baginski95/Home-automation-system/Praca dyplomowa - System sterowania wybranymi funkcjami instalacji w domu jednorodzinnym, Filip Bagiński.pdf

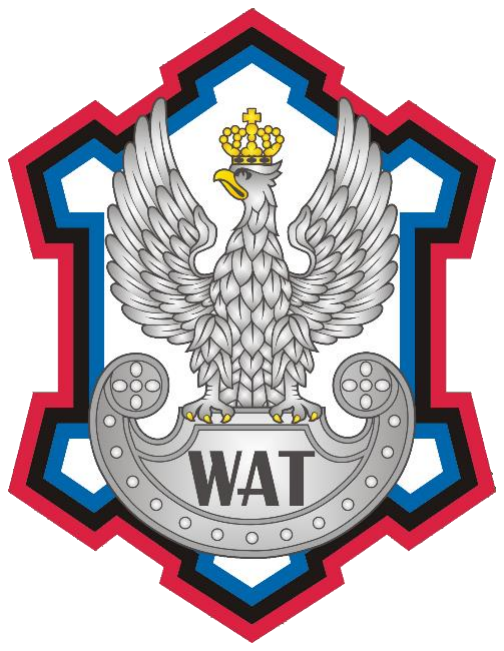
[picture p1: figure]

### WARSZAWA 2019

## WOJSKOWA AKADEMIA TECHNICZNA

### im. Jarosława Dąbrowskiego

## WYDZIAŁ ELEKTRONIKI

# PRACA DYPLOMOWA

### UKŁAD STEROWANIA WYBRANYMI FUNKCJAMI INSTALACJI W DOMU JEDNORODZINNYM

(temat pracy dyplomowej)
Filip Mikołaj BAGIŃSKI s. Jacka

(stopień wojskowy, tytuł zawodowy, imiona i nazwisko, imię ojca dyplomanta)

## ELEKTRONIKA I TELEKOMUNIKACJA

(kierunek studiów)
INŻYNIERIA SYSTEMÓW BEZPIECZEŃSTWA
(specjalność)
STACJONARNE STUDIA PIERWSZEGO STOPNIA - INŻYNIERSKIE
(forma i rodzaj studiów)*)

dr inż. Marek SUPRONIUK

(stopień wojskowy, tytuł i stopień naukowy, imię i nazwisko promotora pracy dyplomowej)

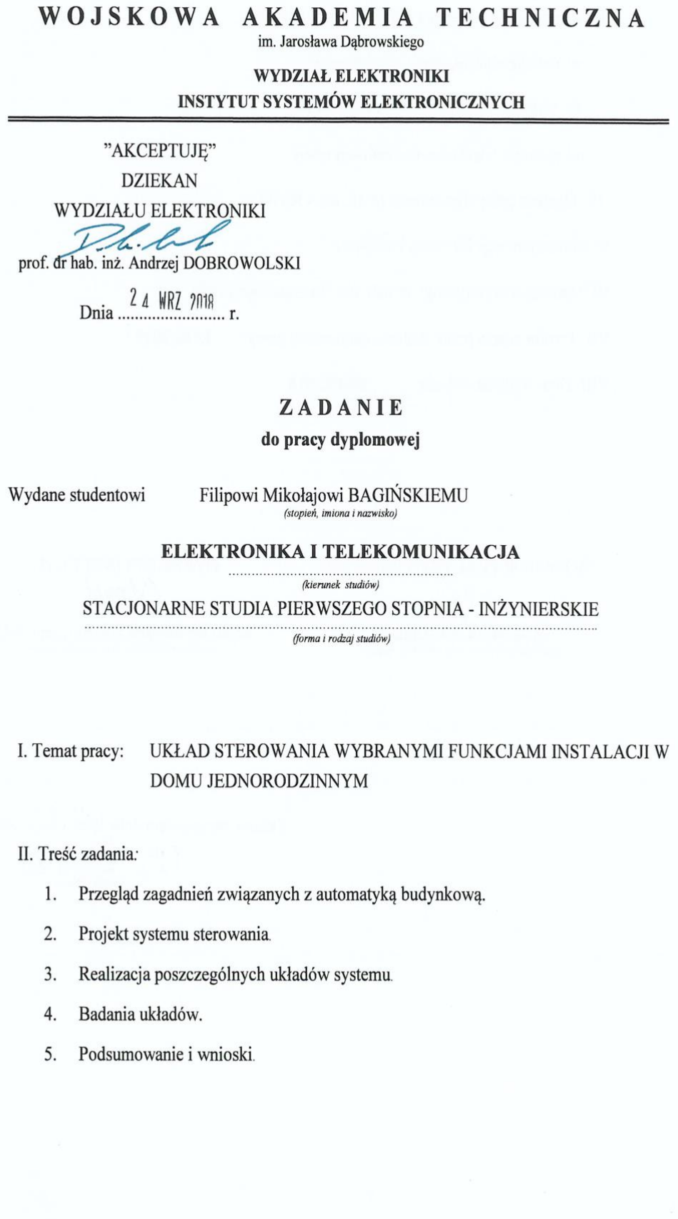
[picture p2: page 2]

### WARSZAWA 2019

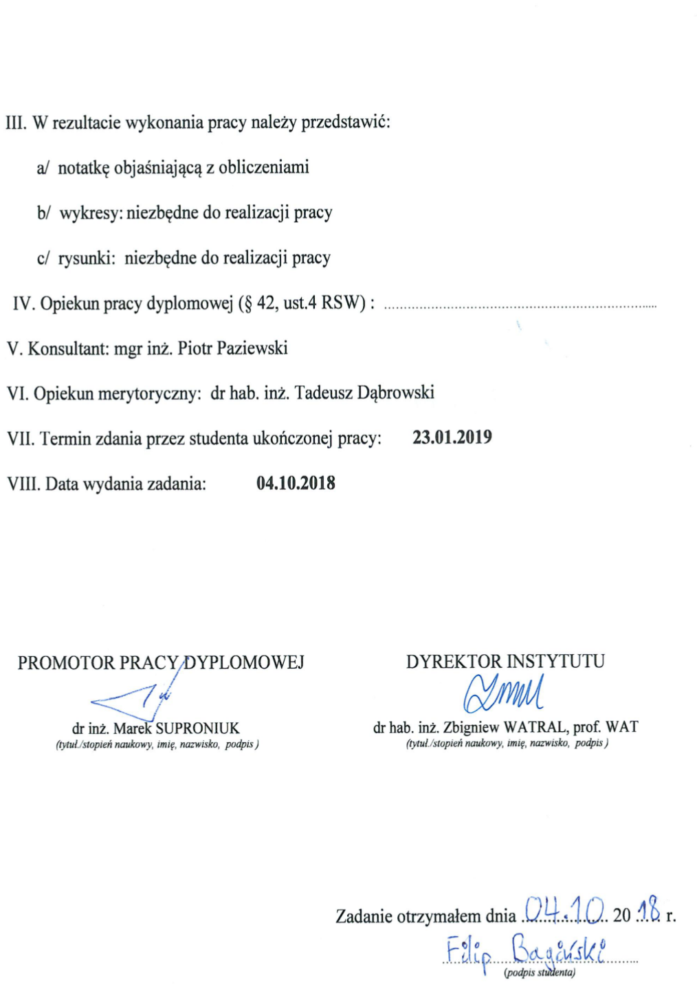
[picture p3: page 3]

### WARSZAWA 2019

SPIS TREŚCI

Wstęp

Pierwsze systemy automatyki domowej zostały stworzone już w ubiegłym wieku.

Zapewniają wygodę oraz bezpieczeństwo osób użytkujących, a także umożliwiają obniżenie

kosztów korzystania z energii elektrycznej. Pojęcie automatyki domowej obejmuje między

innymi systemy sterujące oświetleniem, obsługujące rolety, regulujące temperaturę

w pomieszczeniu, a także alarmowe, czy informujące o zagrożeniu życia lub zdrowia [1].

Bywają też bardzo pomocne dla osób o ograniczonych zdolnościach ruchowych.

W dzisiejszych czasach coraz częściej spotyka się domy wyposażone w systemy

zarządzające poszczególnymi funkcjami instalacji domowej. Pomimo spadku cen elementów

elektronicznych w ostatnich latach ceny systemów automatyki domowej są wciąż wysokie.

Niniejsza praca ma na celu stworzenie taniego systemu, który będzie sterować głównym

oświetleniem w pomieszczeniu, gniazdem elektrycznym oraz roletą. Komunikacja pomiędzy

układami realizowana będzie bezprzewodowo. W ramach pracy zostaną zaprojektowane i

zmontowane na płytkach uniwersalnych układ nadawczy w formie pilota posiadającego pięć

przycisków wraz z nadajnikiem podczerwieni oraz układy odbiorcze realizujące poszczególne

funkcje.

### 1. Przegląd wybranych systemów automatyki domowej

Na rynku jest wiele systemów automatyki domowej różnych producentów, które odróżnia

wykorzystana technologia, cena, sposób komunikacji pomiędzy układami oraz realizowane

funkcje.

### 1.1 Systemy bezprzewodowe

Systemy bezprzewodowe podczas montażu nie wymagają ingerencji w już istniejącą

instalację elektryczna. Z tego powodu zazwyczaj jego montaż jest łatwy. Wykorzystując

transmisję radiową w komunikacji pomiędzy układami mogą wystąpić zakłócenia. Poważną

wadą takich systemów jest konieczność użycia zasilania bateryjnego dla niektórych urządzeń,

co wymaga wymiany baterii po pewnym czasie.

a. Fibaro

Jeden z polskich systemów bezprzewodowych automatyki domowej, który umożliwia na

przykład sterowanie oświetleniem, roletami, zdalne monitorowanie budynku, a także może być

zintegrowany z systemami grzewczymi czy zabezpieczającymi. Głównym elementem systemu

jest centrala, która kontroluje całą jego prace. Urządzenia systemu Fibaro zawierają specjalny

układ obsługującego protokół Z-wave w celu komunikacji pomiędzy urządzeniami. Protokół

ten używa pasma o wartości 868,42 megaherców [2]. Sterowanie poszczególnymi modułami

spełniającymi określone funkcje odbywa się przy pomocy zwykłych włączników lub

korzystając z urządzeń mobilnych, czy poprzez stronę internetową.

b. xComfort

Kolejnym przykładem systemu bezprzewodowego może być xComfort, który ma

możliwość sterowania oświetleniem, temperaturą pomieszczenia, roletami oraz innymi

urządzeniami. Dodatkowo producent dostarcza | czujniki pozwalające na monitorowanie stanu
temperatury w pomieszczeniu, detekcję zalania, dymu, czy ruchu. | Posiada główną jednostkę

zarządzającą całym systemem, a sterowanie odbywa się przy użyciu sygnałów wysyłanych do

odbiorników sterujących poszczególnymi układami, które realizują odpowiednią funkcję.

Użytkownik obsługuje go przy pomocy aplikacji mobilnej, panelu zamontowanego na ścianie,

czy programowalnego pilota sterującego [4].

### 1.2 Systemy kablowe

Charakteryzują się przewodową komunikacją pomiędzy układami dzięki czemu transmisja

nie jest podatna na zakłócenia radiowe. Przeważnie są droższe od bezprzewodowych ,a podczas

montażu wymagają specjalistycznej wiedzy na jego temat.

a. KNX

Komunikacja pomiędzy układami tego systemu może być realizowana przy użyciu wielu

mediów transmisyjnych. Poprzez instalację elektryczną w budynku, fale radiowe, czy sieć

Ethernet. Jednak najczęściej stosowanym medium transmisji jest skrętka dwuparowa. Nie

posiada centrali, która zarządzałaby całą instalacją. Jest systemem rozproszonym. Korzysta z

Europejskiej Magistrali Komunikacyjnej opracowanej wspólnie przez europejskich

producentów systemów automatyki budynkowej. Stworzony standard komunikacyjny

umożliwia dołączenie do systemu urządzeń pochodzących od innych producentów. Instalacja

systemu KNX wymaga posiadania sporej wiedzy na jego temat, a także surowego stanu

budynku. Dzięki niemu możliwe jest między innymi sterowanie oświetleniem, temperaturą

pomieszczenia, roletami, kontrolą dostępu czy też zarządzanie systemem alarmowym [6].

b. Nexo

Polski system firmy Nexwell może sterować oświetleniem, roletami, regulować

temperaturę pomieszczenia oraz zarządzać systemem alarmowym. Współpracuje wyłącznie z

urządzeniami producenta. Zarządzanie poszczególnymi modułami i podejmowanie decyzji

odbywa się poprzez centralę. W razie uszkodzenia centrali nie będą dostępne zaawansowane

funkcje, lecz będzie można sterować poszczególnymi funkcjami przy użyciu włączników.

System może być obsługiwany za pomocą aplikacji mobilnej NexoVision, strony internetowej

oraz wiadomości SMS. Centrala przeważnie połączona jest z modułami przewodowo. Jednak

jest również możliwość komunikacji bezprzewodowej z modułami, które zostały do tego

zaprojektowane[2].

### 2. Przedstawienie projektu

Celem projektu jest wykonanie czterech urządzeń. Jednego układu nadawczego oraz trzech

układów odbiorczych, które mają pełnić funkcję prostego systemu realizującego poszczególne

funkcje automatyki domowej.

### 2.1. Założenia projektu

Zadaniem układu nadawczego jest możliwość przesyłania sygnału w podczerwieni przy

użyciu standardu RC5, który jest odbierany i dekodowany przez układy odbiorcze.

W zależności od użytego przycisku układu nadawczego przypisany do niego układ odbiorczy

reaguje i wykonuje odpowiednią funkcję.

Projekt ma pokazać, że przy niewielkim nakładzie finansowym i łatwo dostępnych

elementach elektronicznych jest możliwość stworzenia prostego systemu sterującego

wybranymi funkcjami instalacji w domu.

Na rys. 2.1. przedstawiony jest schemat blokowy opisywanego systemu składający się

z poszczególnych modułów układu nadawczego oraz modułów układów odbiorczych. Każdy z

układów posiada moduł odpowiedzialny za zasilanie. Układ odbiorczy nr 1 jest zasilany z sieci,

układ odbiorczy nr 2 bateryjnie, a układ odbiorczy nr 3 za pomocą akumulatora. Układ

nadawczy zawiera mikrokontroler, który odpowiedzialny jest za reakcję na odpowiedni

przycisk i wysłanie zakodowanej ramki danych poprzez nadajnik podczerwieni. Natomiast

zadaniem mikrokontrolerów znajdujących się w układach odbiorczych jest odebranie

zakodowanej ramki danych korzystając z odbiornika podczerwieni i wykonaniu odpowiedniej

funkcji jeżeli wysłana ramka danych skierowana jest do tego układu, a jeśli nie to

mikrokontroler porzuca odebraną ramkę danych i oczekuje na odebranie następnej. Układ

odbiorczy nr 1 włącza i wyłącza urządzenie podłączone do sieci. Zadaniem układu odbiorczego

nr 2 jest sterowanie oświetleniem, a układ odbiorczy nr 3 obsługuje silnik sterujący roletą.

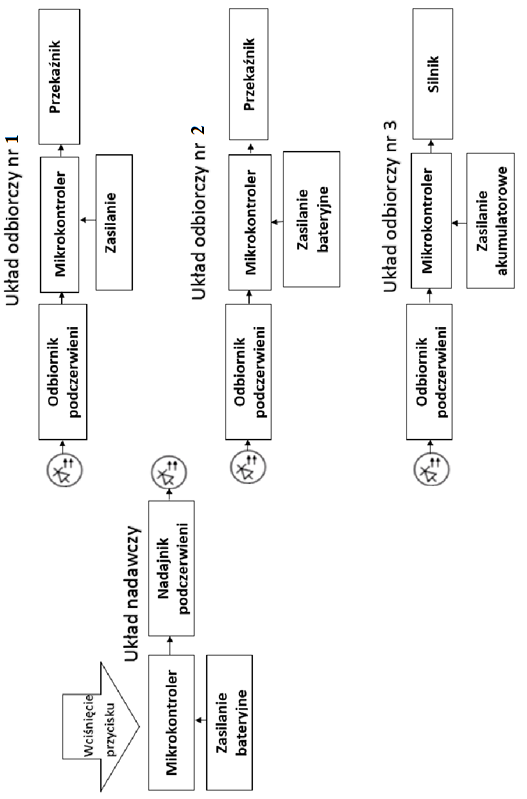
[picture p4: figure]

Rys. 2.1 Schemat blokowy systemu sterującego wybranymi funkcjami instalacji (opracowanie własne)

### 2.2. Opis standardu RC5

Wykorzystywany w projekcie standard RC5 jest jednym z wielu standardów kodowania

sygnałów w podczerwieni. Został stworzony przez firmę Philips ponad 30 lat temu w celu

przesyłania sygnałów z pilotów podczerwieni używanych w sprzęcie RTV.

Zgodnie z tym standardem ramka danych wysyłana z układu nadawczego zawiera 14 bitów.

Trzy początkowe bity to dwa bity startu informujące układ odbiorczy o nadchodzącej ramce

danych oraz bit toggle, który zmienia swój stan na przeciwny po każdym wciśnięciu przycisku.

Później występuje pięć bitów adresu przechowujących adres urządzenia do którego przesyłana

jest ramka. Dzięki nim układ odbiorczy ma możliwość wykrycia czy dana ramka wysyłana

przez układ nadawczy jest skierowana dla niego. Następnie 6 bitów określających funkcję do

wykonania przez układ odbiorczy. Opisywany standard bazuje na kodowaniu bifazowym.

Oznacza to, że każdy przesyłany bit w ramce danych określony jest przez dwa impulsy o

przeciwnych stanach logicznych. Każdy impuls trwa przez dokładnie określony fragment

czasu, w tym wypadku jest to około 889 mikrosekund. Dlatego też czas trwania całego bitu

wynosi około 1778 mikrosekund. Podczas transmisji wykorzystywana jest częstotliwość nośna

równa 36 kiloherców, która jest odpowiednio modulowana w celu uzyskania bitu o pożądanym

stanie logicznym [7]. Przykładowa ramka danych wysyłana przez układ nadawczy znajduje się

na rys. 2.2.

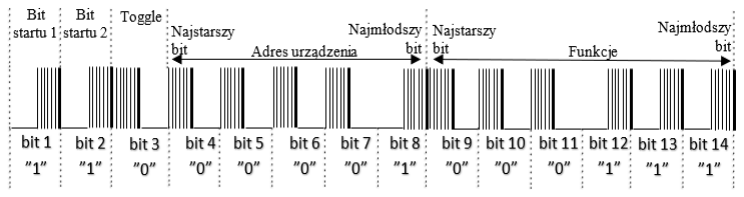
[picture p5: figure]

Rys. 2.2. Przykładowa konstrukcja ramki danych w standardzie RC5 wysyłanej przez układ nadawczy (opracowanie własne)

Od strony części odbiorczej po odfiltrowaniu częstotliwości nośnej przez odbiornik

podczerwieni na jego pinie sygnałowym generowana jest zanegowana ramka danych. Negacja

otrzymanej ramki spowodowana jest występującym tranzystorem bipolarnym na jego wyjściu.

Na rys. 2.3 pokazano ramkę widzianą od strony mikrokontrolera w układzie odbiorczym

wysłanej przez układ nadawczy w takiej konfiguracji, jak przedstawia rys. 2.2.

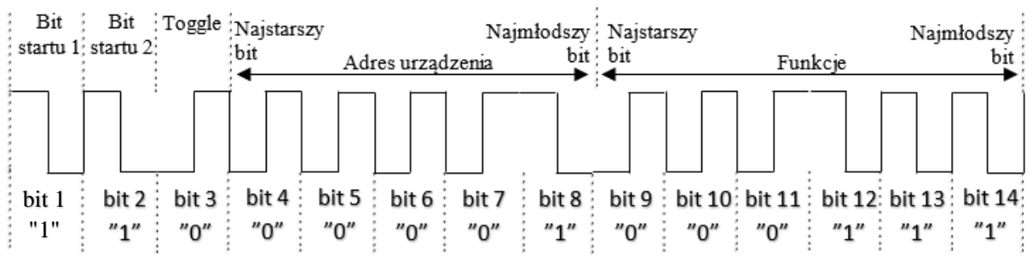
[picture p6: figure]
bit 1 "1"

Rys. 2.3 Konstrukcja ramki danych odebranej przez mikrokontroler w układzie odbiorczym (opracowanie własne)

Jeżeli układ nadawczy ma wysłać bit o wartości logicznej jeden potrzebna jest przerwa w

nadawaniu częstotliwości nośnej przez 889 mikrosekund, a następnie jej emitowanie przez

889 mikrosekund. Podczas wysyłania bitu o wartości logicznej zero należy pierw generować

częstotliwość nośną po czym następuje przerwa w jej emisji także w ciągu 889 mikrosekund.

Rys. 2.4 przedstawia, jak wysłać bit o pożądanych stanach logicznych dla standardu RC5.

Można zauważyć, że od strony układu nadawczego, każdy bit niosący informację posiada

zbocze w połowie okresu czasu trwania bitu [7].

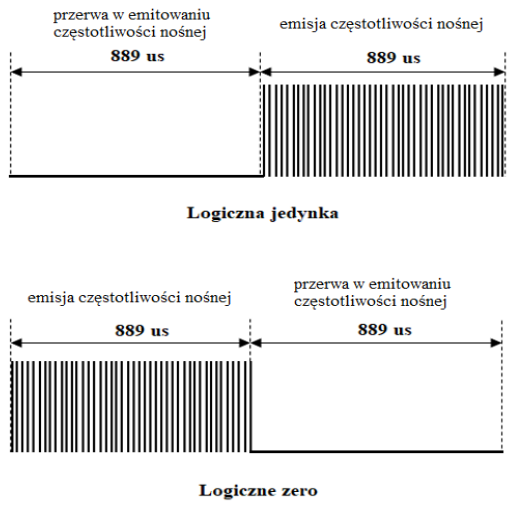
[picture p7: figure]

Rys. 2.4 Reprezentacja stanów logicznych dla układu nadawczego z częstotliwością nośną 36 kiloherców (opracowanie własne)

Dla wartości logicznej jeden jest to zbocze narastające, a bit o wartości logicznej zero

posiada zbocze opadające. W przypadku układu odbiorczego po odfiltrowaniu częstotliwości

nośnej sygnału przez odbiornik podczerwieni otrzymujemy poszczególne bity ramki danych w

postaci dwóch impulsów o różnych stanach. Mikrokontroler układu odbiorczego wykrywa stan

niski na pinie sygnałowym odbiornika podczerwieni podczas emitowania częstotliwości nośnej

przez układ nadawczy, a wykrywa stan wysoki podczas braku nadawania częstotliwości nośnej,

co pokazuje rys. 2.5. Występujący na wyjściu odbiornika podczerwieni tranzystor bipolarny

wchodzi w stan nasycenia po wykryciu fali nośnej, dlatego też odebranie sygnału w postaci fali

nośnej jest sygnalizowane stanem niskim. Podczas braku emitowania fali nośnej przez układ

nadawczy na wyjściu odbiornika podczerwieni panuje stan wysoki, co zapewnia rezystor

podciągający zawarty w jego budowie. Oznacza to, że stany logiczne poszczególnych bitów

wysłanych przez układ nadawczy są negowane przez odbiornik podczerwieni, co należy

uwzględnić podczas pisania kodu źródłowego dla układu odbiorczego.

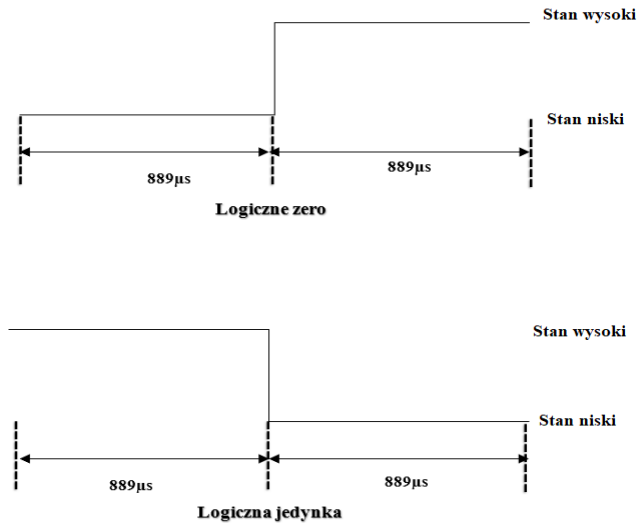
[picture p8: figure]

Rys. 2.5 Reprezentacja stanów logiczny dla układu odbiorczego po odfiltrowaniu częstotliwości nośnej przez odbiornik podczerwieni (opracowanie własne)

Przedstawione wyżej informacje są wystarczające, aby napisać kod źródłowy dla układu

nadawczego w celu nadawania ramki danych w standardzie RC5 oraz dla układów odbiorczych,

które będą miały możliwość dekodowania nadsyłanych ramek danych.

### 2.3. Dobór platformy

Ważną decyzją jest dobór platformy na której będzie opierał się cały system. Obecnie na

rynku jest wiele dostępnych urządzeń takich, jak mikrokontrolery, płytki rozwojowe, czy też

komputery jednopłytkowe.

a. Raspberry Pi

Platforma ta jest jednopłytkowym komputerem osobistym. Posiada własny system

operacyjny Raspbian, który jest częścią rodziny Linux. Raspberry Pi wyposażony jest

w procesor BCM2837, który jest wyposażony w cztery 64-bitowe rdzenie Cortex-A53 [10].

Na płytce znajdują się moduły wi-fi oraz Bluetooth. Jest też złącze HDMI służące do

podłączenia monitora oraz złącza USB, dzięki którym możemy podłączyć mysz oraz

klawiaturę. Zasilanie doprowadzone jest przez złącze USB. W projekcie nie zostanie

wykorzystana opisywana platforma z powodu nadmiernej ilości zbędnych modułów oraz

trudności napisania kodu programu, który miałby na celu realizować transmisję przy

wykorzystaniu standardu RC5.

b. Arduino

Gotowy zestaw uruchomieniowym, który został stworzony, dla osób chcących nauczyć się

pisać programy dla mikrokontrolerów, ale nie miały z tym za dużo wspólnego. Platforma

wykorzystuje mikrokontrolery z rodziny AVR. Zasilanie odbywa się przez złącze USB

znajdujące się na płytce ewaluacyjnej. Do wgrania kodu źródłowego nie jest potrzebny

zewnętrzny kompilator, ponieważ płytka wyposażona jest już w zaprogramowany

mikrokontroler służący do komunikacji z komputerem. Programowanie Arduino wspierane jest

przez oprogramowanie komputerowe, które zawiera biblioteki ułatwiające pisanie kodu

źródłowego mikrokontrolera, dzięki czemu nie trzeba znać poszczególnych nazw rejestrów

mikrokontrolera AVR. Arduino nie zostanie wykorzystana w projekcie z powodu miejsca

w obudowie jakie urządzenia mogłyby zajmować, gdyby została użyta ta platforma [11].

c. STM32

Są to mikrokontrolery 32-bitowe. W swojej strukturze zawiera wiele portów

wejścia/wyjścia, zegarów, konwerterów analogowo-cyfrowych oraz wielu innych modułów.

Producent udostępnia pokaźną ilość bibliotek pomagających napisać kodu źródłowy, ponieważ

napisanie programu dla mikrokontrolera 32-bitowego nie jest łatwym zadaniem i zazwyczaj

wymaga dobrej znajomości architektury mikrokontrolera oraz wygenerowania dużej ilości

kodu w celu wykonania prostych funkcji dlatego nie będzie on wykorzystany w niniejszym

projekcie.

d. AVR

Rodzina tych 8-bitowych mikrokontrolerów dzieli się na dwa typy. Jednym z nich jest

ATtiny, którego zasoby sprzętowe są stosunkowe małe, niewielka ilość pamięci operacyjnej

oraz przechowującej kod źródłowy. Posiadają przynajmniej jeden zegar sprzętowy. ATtiny

umieszczone jest w małej obudowie, która zawiera 6 pinów w najmniejszej wersji. Kolejnym

typem tej rodziny mikrokontrolerów jest ATmega, który ma większe zasoby sprzętowe, niż

ATtiny. Posiada więcej pamięci operacyjnej oraz pamięci FLASH. Ma przynajmniej dwa

zegary sprzętowe. W swojej strukturze zawiera przetworniki analogowo-cyfrowe, a jego

budowa zawiera do 100 pinów. Producent tych mikrokontrolerów udostępnia biblioteki przez

co dostęp do poszczególnych rejestrów mikrokontrolera zarządzających jego pracą jest bardzo

prosty. Z uwagi na małą zajętość miejsca oraz prostotę programowania tych mikrokontrolerów

oba typy zostały użyte w niniejszym projekcie.

### 3. Układ nadawczy

### 3.1. Budowa układu nadawczego

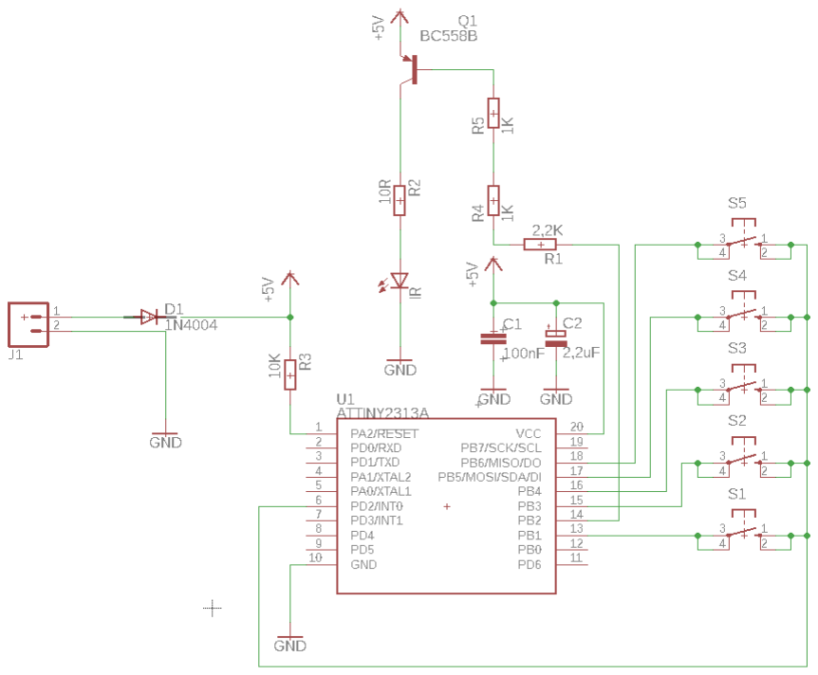
[picture p9: figure]

Rys. 3.1 Schemat połączeń dla układu nadawczego (opracowanie własne)

Na rysunku 3.1 znajduje się schemat połączeń pomiędzy elementami układu nadawczego.

Układem zarządza niewielki mikrokontroler ATtiny2313 do którego doprowadzonych jest pięć

przycisków. Każdy z klawiszy podłączony jest wspólnym połączeniem do pinu PD2, który

wykorzystano do wykrywania przerwań zewnętrznych w tym przypadku wywołanych

naciśnięciem przycisku. Z drugiej strony każdy przycisk podłączony jest do innego pinu portu

B, aby mikrokontroler był w stanie zidentyfikować naciskany przycisk. Rezystory R1, R4 i R5

zostały użyte w celu ograniczenia natężenia prądu płynącego przez bazę tranzystora. Pin PA2

należy doprowadzić do dodatniej szyny zasilania, ponieważ jedną z ról tego pinu jest

resetowanie mikrokontrolera, jeżeli wystąpi na nim stan niski. Zastosowano rezystor R1 w celu

ograniczenia prądu pobieranego przez pin PA2. Pin VCC podłączono do dodatniej szyny

zasilania, a pin o nazwie GND doprowadzono do ujemnego bieguna baterii. Są to piny

odpowiedzialne za zasilanie mikrokontrolera. Różnica potencjałów pomiędzy tymi pinami

powinna zawierać się w przedziale od 4,5 woltów do 5,5 woltów jak wynika to z noty katalogowej. Z powodu braku dostępności baterii o takiej wartości napięcia, a zarazem małych

rozmiarach w projekcie użyto baterii o wartości napięcia 6 woltów. Dioda prostownicza

1N4004 chroni układ przed niepoprawnym podłączeniem biegunów baterii do układu.

Dodatkowo podczas normalnej pracy na diodzie odkłada się napięcie o wartość 0,7 woltów

przez co różnica potencjałów pomiędzy pinami VCC i GND jest zgodna z zaleceniami

producenta. Złącze J1 służy do podłączenia baterii. Pomiędzy pinem VCC do którego

doprowadzone jest zasilanie, a masą zostały włączone równolegle kondensator elektrolityczny

oraz ceramiczny, których zadaniem jest odpowiednia filtracja zasilania. Pomimo zasilania

stałym napięciem do zasilania przedostają się zakłócenia spowodowane impulsową pracą

nadajnika podczerwieni, a także charakterem pracy samego mikrokontrolera, którego wartość

taktowania zegara została ustawiona programowo na wartość 8 megaherców. Poprzez pin PB2

sterowany prądem bazy tranzystor będzie włączał i wyłączał diodę podczerwieni zgodnie ze

standardem RC5 w celu wysłania ramki danych skierowanej do układu odbiorczego

przypisanego do konkretnego klawisza. Rezystor R2 ogranicza prąd płynący przez diodę

podczerwieni.

### 3.2. Nadajnik podczerwieni

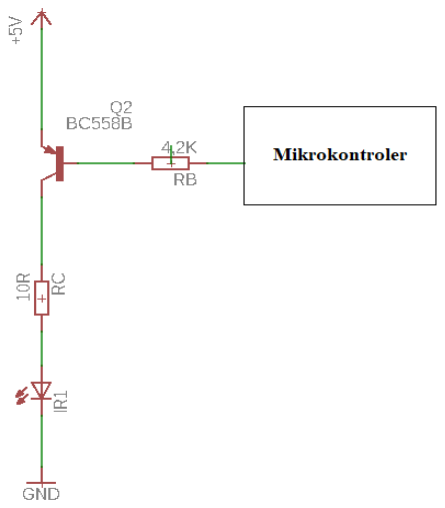
[picture p10: figure]

Rys. 3.2 Schemat nadajnika podczerwieni (opracowanie własne)

Rysunek 3.2 przedstawia jeden z elementów układu nadawczego jakim jest nadajnik

podczerwieni składający się z diody L-53F3BT emitującej falę o długości 940 nanometrów,

która zawiera się w zakresie bliskiej podczerwieni. Wartość ta została określona na podstawie

umieszczonej na rys. 3.3 charakterystyki przedstawiającej zależność intensywności

promieniowania diody od długości emitowanej fali. Kolejnym elementem jest tranzystor PNP

BC558B pracujący jako wzmacniacz w układzie z wymuszonym prądem bazy. W celu

wymuszenia stałego natężenia prądu bazy IB łączy się bazę tranzystora poprzez rezystor RB z

masą wtedy też następuje przepływ prądu kolektora. Obciążeniem tranzystora jest wyżej

wymieniona dioda wraz z szeregowo połączonym rezystorem RC. Zadaniem rezystora RC oraz

RB jest nie tylko odpowiednie zasilenie tranzystora, ale także ustalenie jego stałoprądowego

punktu pracy, czyli stałego napięcia kolektor-emiter UCE i stałego prądu kolektora IC.

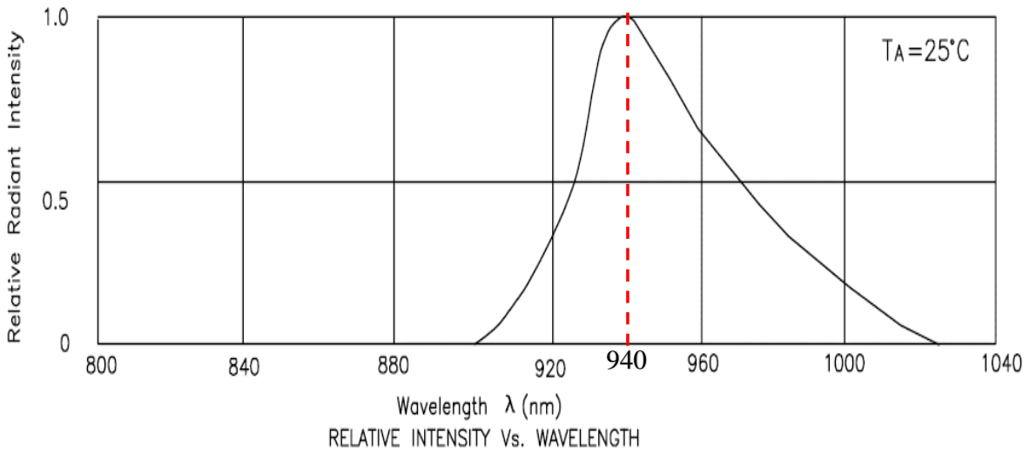
[picture p11: figure]

Rys. 3.3 Zależność intensywności promieniowania diody L-53F3BT od długości emitowanej fali [12]

### 3.3. Dobór elementów nadajnika podczerwieni

Na podstawie noty katalogowej diody podczerwieni emitującej światło podczerwone można

wywnioskować, że maksymalny prąd stały, jaki możemy przez nią przepuścić jest równy 50

miliamperów. Nadajnik podczerwieni projektowany jest tak, aby na diodzie wydzielała się

największa możliwa moc, ponieważ ma to wpływ na zasięg emitowania fali. Na rys. 3.4

znajduje się charakterystyka diody opisująca zależność pomiędzy prądem diody, a jej

napięciem pracy.

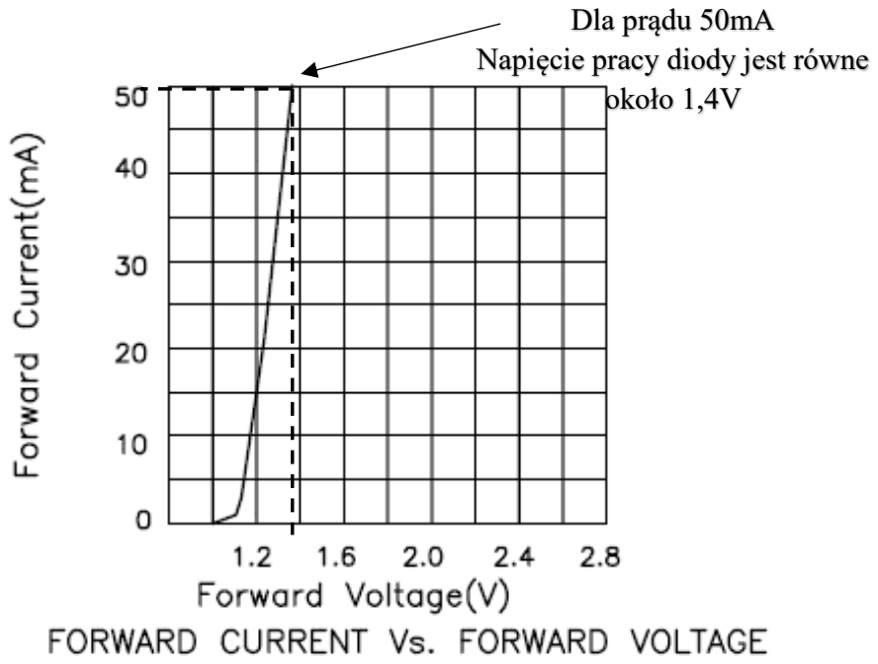
[picture p12: figure]
Dla prądu 50mA Napięcie pracy diody jest równe około 1,4V

Rys. 3.4 Zależność pomiędzy natężeniem prądu diody, a napięciem pracy diody L-53F3BT [12]

Nadajnik podczerwieni będzie emitował falę z częstotliwością 36 kiloherców, gdzie przez

połowę okresu tranzystor będzie w stanie nasycenia i dioda będzie emitowała falę nośną, a

przez drugą połowę okresu tranzystor będzie zatkany i prąd przez diodę nie będzie płynął.

Dzięki takiej pracy nadajnika podczerwieni można zwiększyć moc wydzielaną przez diodę. Z

noty katalogowej diody wynika, że maksymalna moc ciągła wydzielana na diodzie może być

równa 100 miliwatów. Jednak diody podczerwieni przystosowane są do pracy impulsowej. I w

tym wypadku wypełnienie impulsów wynosi 50% jak wynika z omawianego wcześniej

standardu RC5. Korzystając z poniższego wzoru można w przybliżeniu obliczyć maksymalny

prąd w impulsie.

IPMAX =

PMAX
(UD ∙ kD)

=

100mW
(1,4V ∙ 50%)

= 143 mA (1)

Gdzie:

IPMAX - maksymalny prąd w impulsie

PMAX - maksymalna moc ciągła

UD - napięcie pracy diody

kD- wypełnienie impulsów

Mając wartość maksymalnego prądu w impulsie IPMAX oraz napięcie pracy diody UD można

przystąpić do obliczenia wartości rezystancji RC oraz RB. Rysunek 3.5 obrazuje rozkład prądów

i napięć dla nadajnika podczerwieni. Dla napięcia zasilającego UZAS równego 5 woltów

założony punkt pracy tranzystora ma wartości IC wynoszącą 143 miliamperów z powodu

obliczonego maksymalnego prądu w impulsie dla diody podczerwieni oraz napięcia kolektor-

emiter tranzystora UCE wynoszącego -2 woltów. Pokazana na rys. 3.6 charakterystyka pozwala

na wyznaczenie napięcia między bazą, a emiterem UBE w zależności od prądu kolektora IC. W

projekcie przyjęto wartość napięcia UBE równą -0,8 woltów. W celu wyznaczenia prądu bazy

IB potrzebna jest wartość współczynnika wzmocnienia tranzystora hFE, którą można wyznaczyć

korzystając z charakterystyki udostępnionej w nocie katalogowej, a przedstawionej na rys. 3.7.

Posiadając wyżej wymienione wartości można przystąpić do obliczeń.

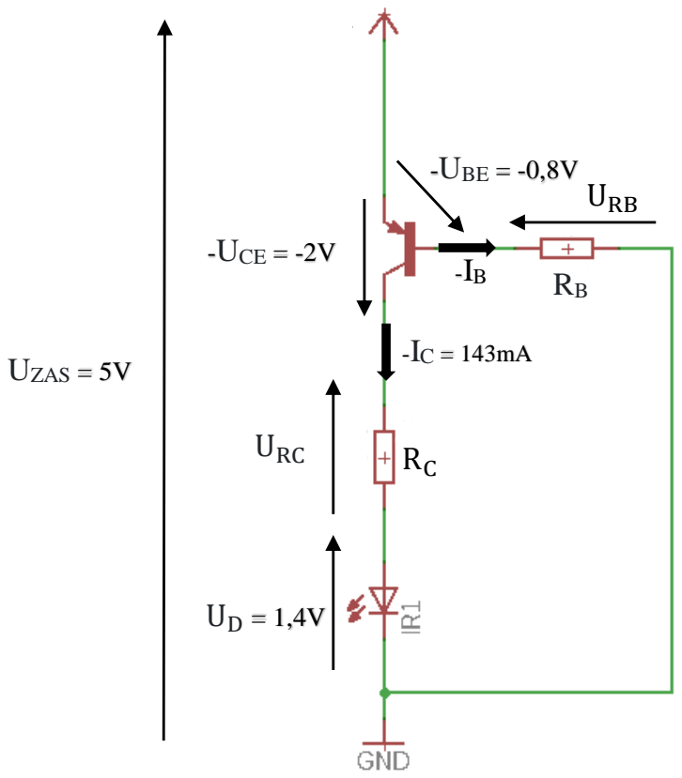
[picture p13: figure]
UZAS; -UBE; -UCE; URC; URB

Rys. 3.5 Rozkład napięć i prądów nadajnika podczerwieni (opracowanie własne)

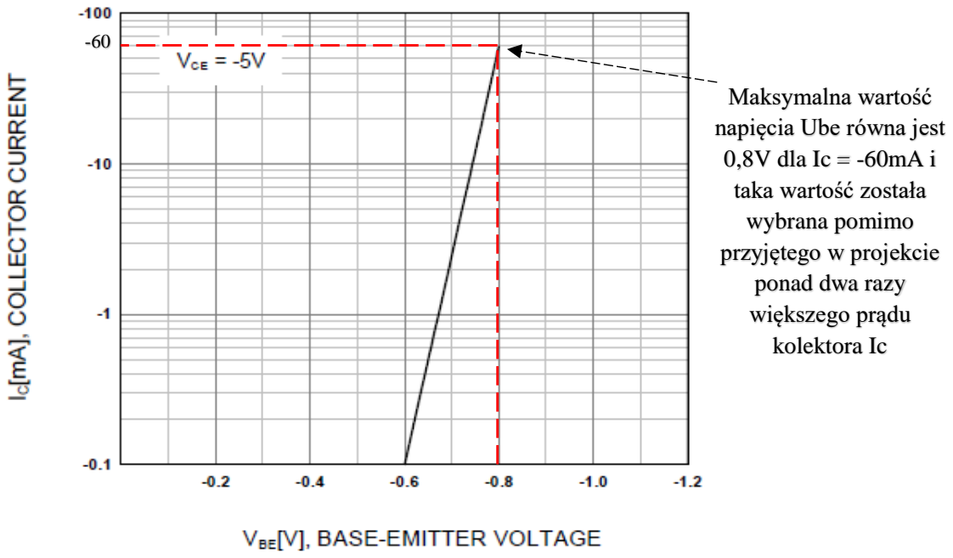
[picture p14: figure]
Maksymalna wartość napięcia Ube równa jest 0,8V dla Ic = -60mA i taka wartość została wybrana pomimo przyjętego w projekcie ponad dwa razy większego prądu kolektora Ic

Rys. 3.6 Zależność między napięciem baza-emiter UBE, a prądem kolektora IC dla tranzystora BC558B [13]

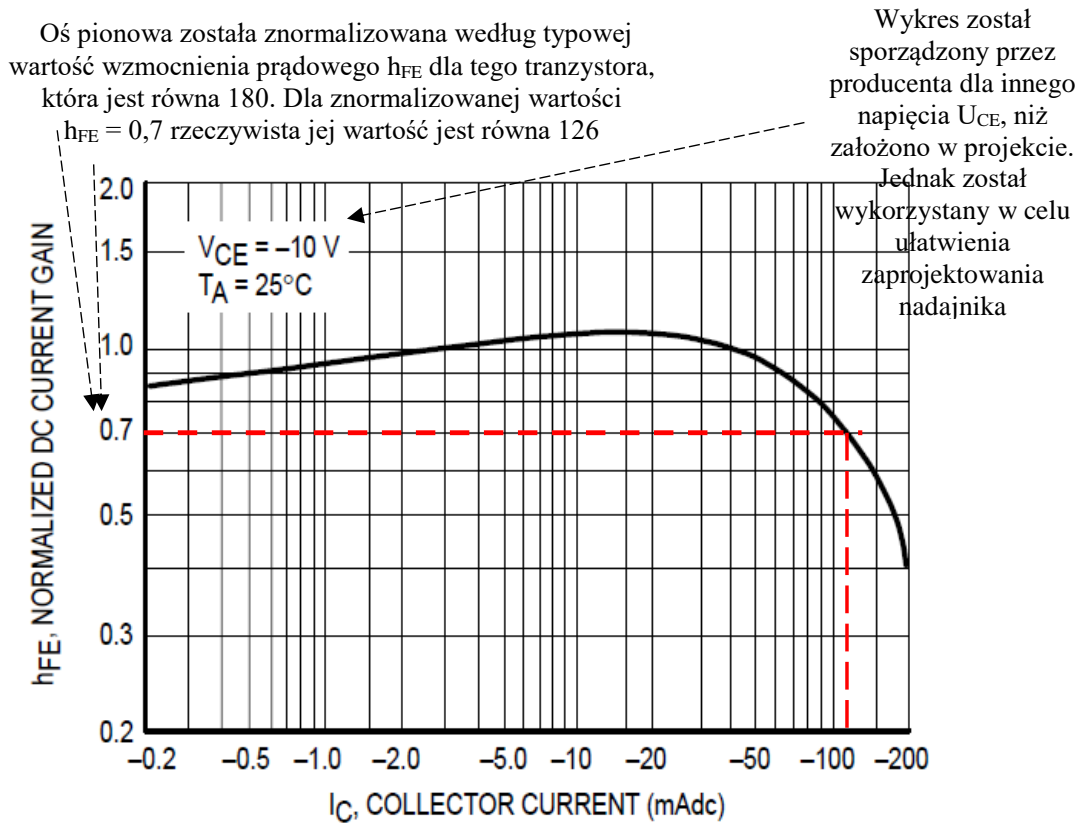
[picture p15: figure]
Wykres został sporządzony przez producenta dla innego napięcia UCE, niż założono w projekcie. Jednak został wykorzystany w celu ułatwienia zaprojektowania nadajnika

Rys. 3.7 Zależność wzmocnienia prądowego hFE od prądu kolektora IC dla tranzystora BC558B [13]

Na podstawie II prawa Kirchhoffa oraz prawa Ohma przy pomocy zaznaczonych na rys. 3.5

rozkładem napięć i prądów można wyprowadzić wzory na szukane rezystancje RC oraz RB.

Oś pionowa została znormalizowana według typowej wartość wzmocnienia prądowego hFE dla tego tranzystora, która jest równa 180. Dla znormalizowanej wartości hFE = 0,7 rzeczywista jej wartość jest równa 126

Obliczanie rezystancji RC:

Wzór opisujący drugie równanie Kirchhoffa dla oczka z kolektorem i emiterem:

UZAS | = UD | + URC − (−UCE) = UD | + IC | ∙ RC − (−UCE) | (2)
UZAS − UD | + (−UCE) = IC | ∙ RC
RC | =
[UZAS − UD | + (−UCE)]
IC

RC =

| | (5V − 1,4V − 2V)
0,143A | = 11,188Ω ≈ 11Ω

Obliczanie rezystancji RB:

Uproszczony wzór na zależność prądu bazy IB od prądu kolektora IC :

| | IB = IC hFE
(3)

IB =

0,143A
126 = 1mA

Wzór opisujący drugie równanie Kirchhoffa dla oczka z bazą i emiterem:

UZAS = URB + (−UBE) = IB ∙ RB + (−UBE) (4)

UZAS − (−UBE) = IB ∙ RB

RB =

[UZAS − (−UBE)]
IB

RB =

(5V − 0,8V)
0,001 A

= 4,2kΩ

### 3.4. Prototyp

Załączony na rys. 3.8 prototyp układu nadawczego został zbudowany na płytce stykowej.

Zmontowany układ ma na celu zbadanie poprawności wysyłanych bitów, co jest warunkiem

poprawnej komunikacji pomiędzy układami. Docelowo układ będzie zasilany baterią 6

woltową jednak prototyp układu zasilany jest z zasilacza firmy Samsung, którego napięcie

wyjściowe wynosi 5 woltów, co niweluje potrzebę obniżenia napięcia zasilania do wymaganej

wartości.

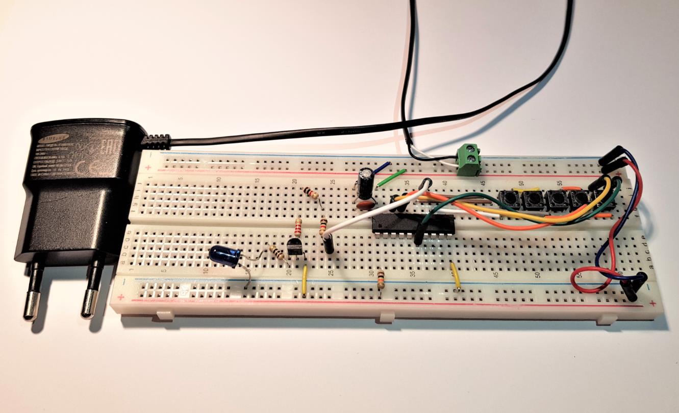
[picture p16: figure]

Rys. 3.8 Prototyp układu nadawczego (opracowanie własne)

Przy pomocy multimetru zmierzono wartość 1,41 woltów napięcia pracy diody

podczerwieni, która nieco odbiega od założonych wartości. Również założone natężenie prądu

kolektora IC odbiega od rzeczywistego. Multimetr zmierzył wartość natężenia prądu kolektora

równą 86 miliamperów przez co założony punkt pracy tranzystora różni się od rzeczywistego.

Podczas pomiaru napięcia pracy diody oraz prądu kolektora nóżka bazy tranzystora została

doprowadzona poprzez rezystory o obliczonej wartości 4,2 kiloomów do masy układu. Pomiar

tych wartości przy założonej w projekcie pracy impulsowej nadajnika podczerwieni byłby mało

wiarygodny dla wykorzystywanego multimetru i dlatego pomiary zostały wykonane bardzo

szybko z powodu możliwości uszkodzenia elementów nieprzystosowanych do pracy ciągłej dla

tak dużego natężenia prądu. Różnice między wartościami założonymi i pomierzonymi

wynikają z użycia kilku uproszczeń, które miały na celu ułatwić zaprojektowanie nadajnika

podczerwieni. Otrzymane wartości działającego układu są akceptowalne w ramach projektu.

Jednak będzie to miało wpływ na długość zasięgu emitowanej fali.

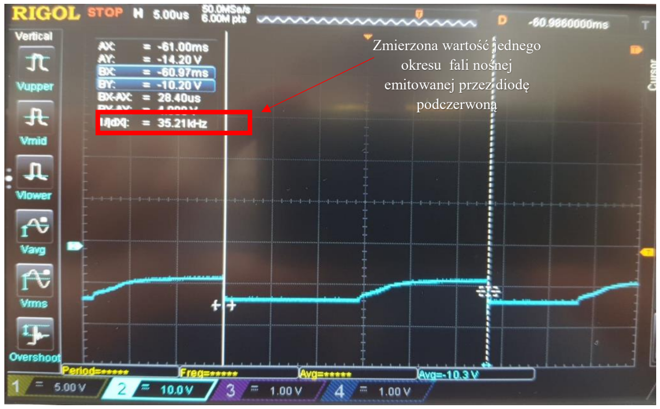
[picture p17: figure]
Zmierzona wartość jednego okresu fali nośnej emitowanej przez diodę podczerwoną

Rys. 3.9 Przebieg napięcia odkładanego na diodzie podczerwieni podczas emitowania fali nośnej (opracowanie własne)

W celu sprawdzenia częstotliwości nośnej sygnału emitowanego przez układ nadawczy

podłączono sondy oscyloskopu do anody oraz katody diody podczerwonej. Rysunek 3.9

przedstawia zaznaczony wskaźnikami pionowymi jeden okres tego sygnału. Zmierzona

oscyloskopem wartość częstotliwości nośnej wyniosła 35.21 kiloherców. Częstotliwość nośna

emitowanego sygnału jest bardzo zbliżona do wartości założonej w projekcie. Różnice w

wartościach wynikają z błędów pomiarowych oraz samej pracy mikrokontrolera. Pomimo tej

różnicy układy odbiorcze przy pomocy odbiornika podczerwieni będą odbierały nadchodzący

sygnał, ponieważ zawiera w swojej budowie filtr środkowoprzepustowy o częstotliwości

środkowej równej 36 kiloherców, który będzie w bardzo małym stopniu tłumił częstotliwość

nośną nadsyłanego sygnału. Jak można zauważyć zbocza narastające nie są strome z powodu

charakteru pracy tranzystora.

### 3.5. Oprogramowanie

Dla mikrokontrolera układu nadawczego okd źródłowy zawarty w załączniku został

napisany w języku C na podstawie informacji zawartych w książce [7] przy użyciu platformy

programistycznej Eclipse. Produkcyjnie mikrokontrolery ATmega mają ustawioną

częstotliwość taktowania 1 megaherca. Rysunek 3.10 ukazuje zrzut ekranu jednej z zakładek

programu mkAVRCalculator w której można zmienić częstotliwość taktowania używanego mikrokontrolera. W celu poprawnego działania programu ustawiono częstotliwość taktowania

8 megaherców.

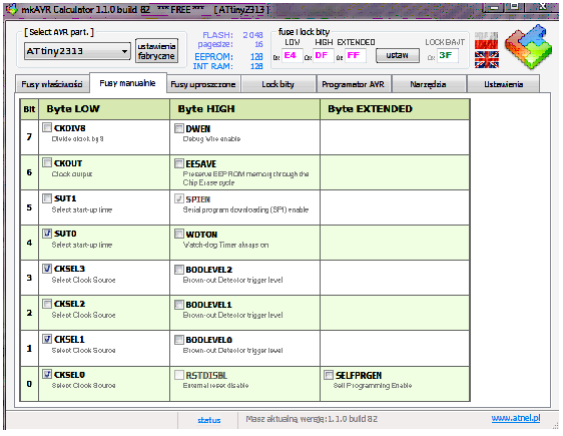
[picture p18: figure]

Rys. 3.10 Zrzut ekranu jednej z zakładek programu mkAVRCalculator (opracowanie własne)

Kod źródłowy został wgrany na mikrokontroler ATtiny2313 za pomocą programatora

USBasp pokazanego na rys. 3.11, który przeznaczony jest do pracy z mikrokontrolerami

z rodziny AVR. Programator pośredniczy w komunikacji pomiędzy mikrokontrolerem, a

komputerem. Napisany program wykorzystując rejestr określający kierunek pinów DDRB

ustawia pin PB2 jako wyjście, aby móc sterować pracą nadajnika podczerwieni. Za pomocą

rejestru TCCR0A oraz TCCR0B użyto zegar sprzętowy, który pozwala generować na PB2

sygnał o częstotliwości 36 kiloherców. Za pomocą rejestrów określających kierunki pinów

podłączone do portu B przyciski zostały ustawione jako wyjścia, a pin PD2 jako wejście.

W pętli głównej programu znajduje się jedynie funkcja wprowadzająca mikrokontroler w stan

niskiego poboru energii, a wyłączany jest po wykryciu przerwania wywołanego stanem

wysokim na PD2. Część kodu źródłowego odpowiedzialna za wysłanie ramki o odpowiednich

wartościach zawarta jest w tym przerwaniu aktywujące się przy wciśnięciu jednego z

przycisków. Mikrokontroler sprawdza jaki przycisk został użyty wykorzystując do tego rejestr

PINB i zaczyna nadawać przypisaną do niego ramkę danych o odpowiednich wartościach.

Emitowanie i przerwa w emitowania częstotliwości nośnej przez okres 889 mikrosekund

odbywa się przy użyciu funkcji wykorzystującej pracę drugiego zegara sprzętowego, który jest

ustawiony za pomocą jego rejestrów TCCR1B, TIFR oraz OCR1A w taki sposób, aby móc

określać czas trwania emitowania częstotliwości nośnej lub jej braku. Zmienna funkcji

określana jest w mikrosekundach. Następnie wykorzystano dwie funkcje wyślij_1 oraz wyślij_

wykorzystując powyżej opisaną funkcję wysyłają bity o odpowiadającej im wartości logicznej.

Działanie tych funkcji polega na odpowiednim włączeniu zegara pierwszego wykorzystując

jego rejestr TCCROA, który odpowiedzialny jest za włączenie generowania sygnału o danej

częstotliwości na pinie PB2.

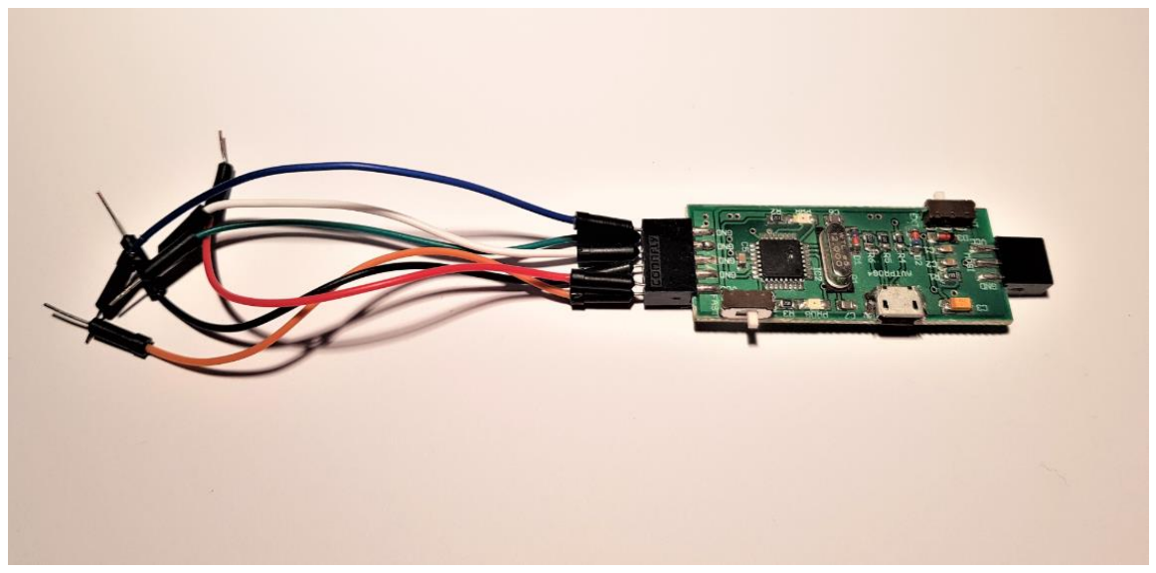
[picture p19: figure]

Rys. 3.11 Fotografia przedstawiająca programator USBasp (opracowanie własne)

### 4. Układy odbiorcze

### 4.1. Budowa układu odbiorczego nr 1

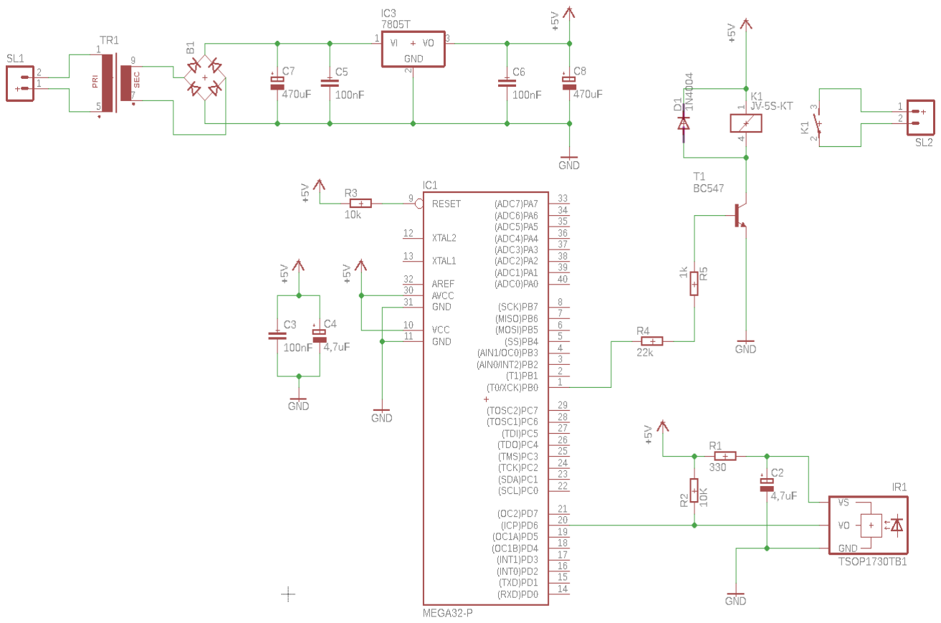
[picture p20: figure]

Rys. 4.1 Schemat układu odbiorczego nr 1 (opracowanie własne)

Na rys. 4.1 pokazany został schemat układu odbiorczego nr 1 różniącego się od układ

odbiorczego nr 2 wyłącznie fragmentem układu odpowiedzialnym za doprowadzenie zasilania.

Z powodu funkcji jaką będzie spełniał jest możliwość doprowadzenia z sieci zasilania prądu

przemiennego o napięciu skutecznym 230 woltów. W celu obniżenia napięcia zasilania do 12

woltów prądu przemiennego zastosowano transformator obniżający napięcie TSZZ 2/007.

Podczas jego wyboru kierowano się napięciem wtórnym, którego wartość powinna być większa

niż wartości napięcia na wyjściu stabilizatora napięcia. Poprawna praca stabilizatora wymaga,

aby jego napięcie wyjściowe było o 2,5 wolta niższe niż napięcie wejściowe. Mając na uwadze

spadki napięć na diodach prostowniczych mostka Graetza przyjęto minimalną różnicę napięć

pomiędzy wejściem stabilizatora, a transformatorem równą 4 wolty. Zwrócono również uwagę

na jego wymiary oraz maksymalne natężenie prądu jakie można uzyskać na wyjściu

transformatora, które powinno być większe od natężenia prądu pobieranego przez układ

odbiorczy. W celu przekształcenia prądu przemiennego na jednokierunkowy prąd tętniący

użyto pełno okresowego prostownika jakim jest mostek Graetza. W każdym półokresie odkłada

się napięcie o wartości 0,7 woltów na każdej z dwóch diod prostowniczych. W Układzie zasilania znajduje się stabilizator napięcia LM7805, który utrzymuje stabilne napięcie na jego

wyjściu o stałej wartości nominalnej wynoszącej 5 woltów w celu zapewnienia wymaganego

napięcia dla mikrokontrolera, odbiornika podczerwieni oraz przekaźnika. Na wejściu oraz

wyjściu stabilizatora dołączono równolegle kondensatory elektrolityczne i ceramiczne w celu

wygładzenia napięcia.

### 4.2. Budowa układu odbiorczego nr 2

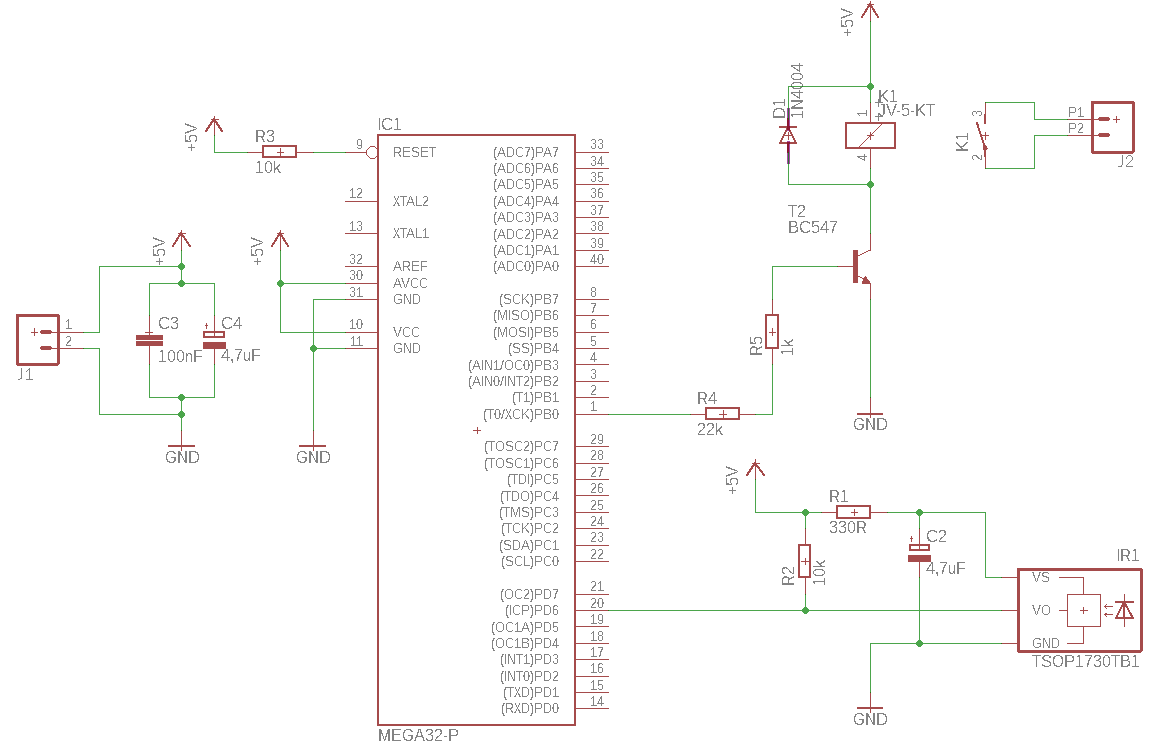
[picture p21: figure]

Rys. 4.2 Schemat układu odbiorczego nr 2 (opracowanie własne)

Na rys. 4.2 przedstawiony został schemat układu odbiorczego nr 2. Mikrokontroler

ATmega32 odpowiada za zarządzanie całym układem. Odbiera sygnał nadchodzący

z odbiornika podczerwieni dekodując ramkę danych określoną standardem RC5 i wykonuje

określoną funkcję. Wyjście sygnałowe odbiornika podczerwieni zostało doprowadzone do pinu

PD6 mikrokontrolera, który odpowiedzialny jest za generowanie przerwań wywołanych

zboczami opadającymi i narastającymi występującymi na tym pinie. Rezystor R1 wraz z

kondensatorem elektrolitycznym C2 odpowiedzialny jest za filtrację zasilania poprzez

eliminację zakłóceń pochodzących od odbiornika podczerwieni ,a rezystor R2 odpowiedzialny

jest za lepsze podciągnięcie wyjściowej linii danych odbiornika podczerwieni do szyny

zasilającej jak wynika z noty katalogowej producenta. Również kondensatory C3 oraz C4 służą

do filtracji zasilania. Układ jest zasilany z baterii podłączonej do złącza J1. Mikrokontroler

sterując prądem bazy popularnego tranzystora BC547B steruje pracę przekaźnika. Wybierając

przekaźnik JV-5S-KT sugerowano się jego napięciem pracy, które zostało dobrane tak, aby było równe napięciu zasilania mikrokontrolera oraz nadajnika podczerwieni. Dioda

prostownicza 1N4004 została umieszczona pomiędzy stykami cewki przekaźnika katodą

skierowaną do napięcia zasilania w celu rozładowania się przez nią napięcia zaindukowanego

w cewce przekaźnika występującego podczas zanikania pola magnetycznego tej cewki.

### 4.3. Budowa układu odbiorczego nr 3

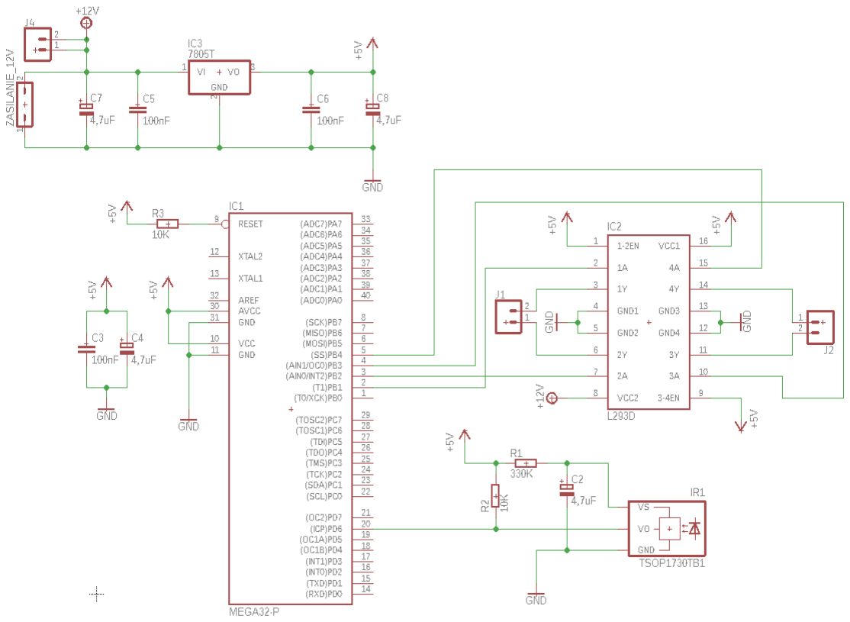
[picture p22: figure]

Rys. 4.3 Schemat układu odbiorczego nr 3 (opracowanie własne)

Układ odbiorczy nr 3, którego schemat przedstawiono na rys. 4.3 będzie pełnił funkcję

zdalnego sterownika rolet. Do tego celu został wykorzystany silnik krokowy unipolarny oraz

sterownik L293D. Sterownik w swojej budowie zawiera dwa mostki H i przeznaczony jest do

sterowania dwoma silnikami prądu stałego jednak przy odpowiednim połączeniu wyjść

sterownika z silnikiem krokowym unipolarnym jest możliwa realizacja jego sterowania podając

na sterownik w odpowiedniej kolejności impulsy sterujące pochodzące z mikrokontrolera.

Układ tak jak pozostałe układy odbiorcze także zawiera mikrokontroler ATmega32 oraz

odbiornik podczerwieni. Silnik zasilany będzie z akumulatora żelowego o wartości napięcia

nominalnego równego 12 woltów. Stabilizator LM7805 utrzymuje stabilne napięcie na jego

wyjściu o stałej wartości nominalnej wynoszącej 5 woltów, ponieważ takim napięciem należy zasilić mikrokontroler oraz odbiornik podczerwieni. Do złącz J1, J2 oraz J4 został odpowiednio

podłączony silnik krokowy unipolarny.

### 4.4. Obliczenia

Na rysunku 4.4 przedstawiona jest część układu odbiorczego nr 1 oraz układu odbiorczego

nr 2 odpowiedzialna za wykonywanie określonej funkcji poprzez włączanie oraz wyłączanie

przekaźnika. Z noty katalogowej wykorzystanego w projekcie przekaźnika JV-5S-KT można

znaleźć wartość rezystancji cewki przekaźnika RP równą 125 omów , nominalnego napięcia UP

wynoszącego 5 woltów, nominalnej mocy jego cewki PP równej 200 miliwatów oraz

minimalnej moc PMIN wynoszącej 130 miliwatów dla której przekaźnik pracuje normalnie.

Mając te wartości obliczono nominalną wartość natężenia prądu cewki za pomocą wzoru na

moc wydzielaną na elemencie podczas pracy ciągłej (5).

PP = UP ∙ IP (5)

IP =

PP
UP

IP =

0,2 W
5V = 40 mA

Gdzie:

PP - nominalna moc cewki przekaźnika

UP - nominalne napięcie cewki przekaźnika

IP - nominalne natężenie cewki przekaźnika

Wartość natężenia prądu kolektora IC tranzystora BC547B powinna być równa obliczonej

wartości nominalnego natężenia prądu cewki przekaźnika. Napięcie zasilania UZAS jest równe

5 wolt. Korzystając z noty katalogowej wykorzystywanego tranzystora wynika, że napięcie

kolektor-emiter UCE wynosi 0,8 woltów dla prądu kolektora IC równego 40 miliamperów. Użyto

jednej z charakterystyk pokazanej na rys. 4.5 w celu oszacowania napięcia baza-emiter UBE.

Przy założonym natężeniu prądu kolektora i napięciu UCE wynika, że UBE wynosi 0,72 woltów.

Dla wybranego natężenia prądu kolektora współczynnik wzmocnienia prądowego hFE wynosi

180. Posiadając wyżej wymienione wartości można przystąpić do obliczenia prądu bazy IB w

celu wyznaczenia brakującej wartości rezystancji RB ograniczającej natężenie prądu bazy.

Natężenie prądu kolektora IC będzie nieco niższe niż założono, ponieważ przy ustalonym

napięciu zasilania 5 woltów występujący spadek napięcia UCE ograniczy go do wartości nieco ponad 34 miliamperów. Taka wartość jest wystarczająca, aby sterować wybranym w projekcie

przekaźnikiem. Z tego samego powodu napięcie odkładane na cewce przekaźnika także będzie

nieco niższe od wartości nominalnej napięcia cewki, co nie będzie wpływało na prawidłową

pracę przekaźnika.

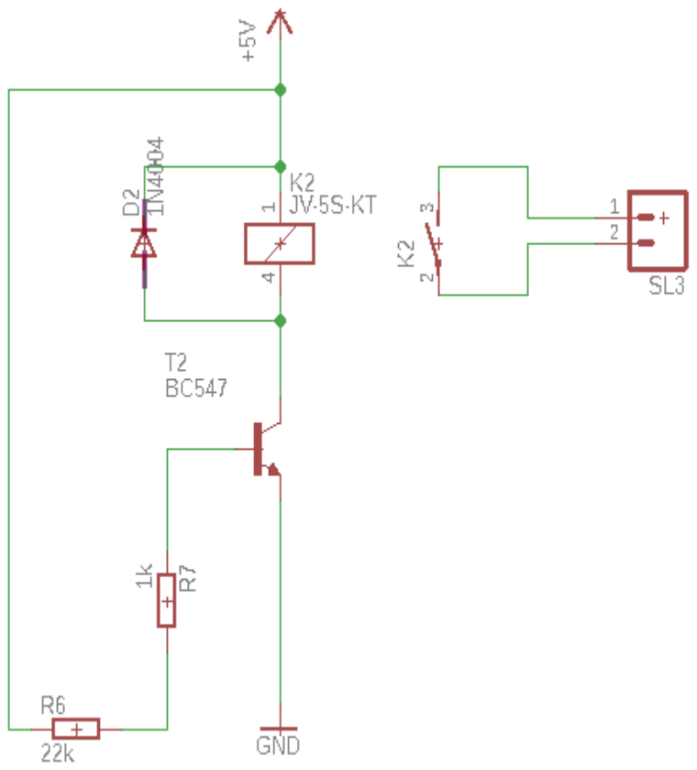
[picture p23: figure]

Rys. 4.4 Część układu odbiorczego nr 1 oraz nr 2 sterująca przekaźnikiem (opracowanie własne)

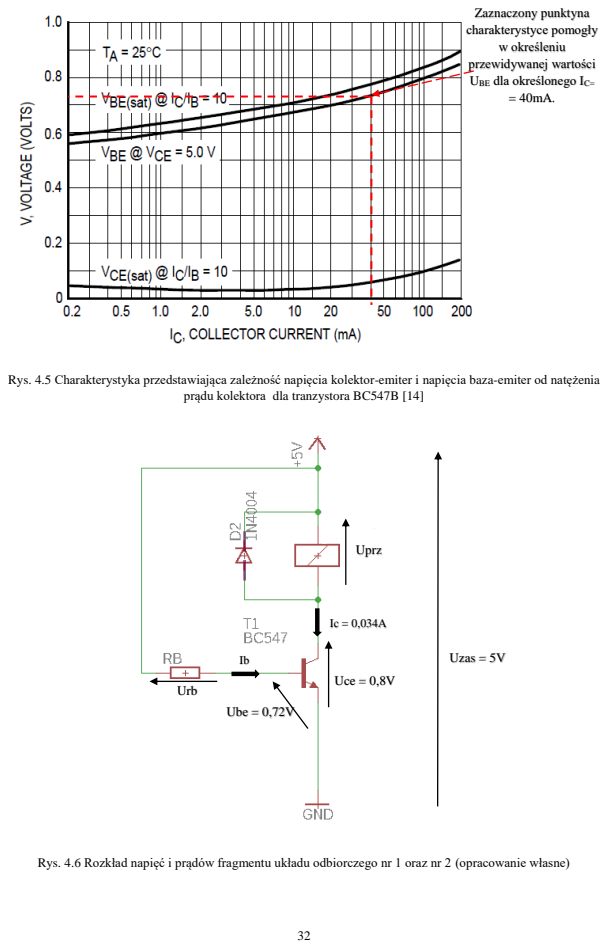
[picture p24: page 31]
Uzas = 5V; Urb; Uce = 0,8V; Uprz; Ube = 0,72V

Zaznaczony punktyna
charakterystyce pomogły
w określeniu
przewidywanej wartości
UBE dla określonego IC=

Rys. 4.5 Charakterystyka przedstawiająca zależność napięcia kolektor-emiter i napięcia baza-emiter od natężenia

prądu kolektora dla tranzystora BC547B [14]

Rys. 4.6 Rozkład napięć i prądów fragmentu układu odbiorczego nr 1 oraz nr 2 (opracowanie własne)

Na podstawie II prawa Kirchhoffa oraz prawa Ohma, a także zaznaczonym na rys. 4.6

rozkładem napięć i prądów w stanie nasycenia tranzystora można wyprowadzić wzory, aby

wyznaczyć przewidywane napięcie na cewce przekaźnika różniące się od nominalnego

napięcia oraz szukaną rezystancję RB. Do obliczeń założono wartość natężenia prądu kolektora

IC równą 34 miliamperów oraz UCE wynoszącą 0,8 woltów. Najpierw obliczono przewidywane

napięcie na cewce przekaźnika UPRZ w celu sprawdzenia wydzielanej mocy, która powinna

mieć większą wartość, niż minimalna moc pracy cewki przekaźnika PMIN.

Wzór opisujący drugie równanie Kirchhoffa dla oczka z kolektorem i emiterem:

UZAS | = UPRZ | + UCE | (6)
UPRZ | = UZAS − UCE
UPRZ | = 5V − 0,8V = 4,2V

Mając tą wartość obliczono moc wydzielaną na cewce przekaźnika w celu sprawdzenia

poprawnej pracy przekaźnika.

PPRZ | = UPRZ | ∙ IC | (7)
PPRZ | = 4,2V ∙ 0,034A = 0,143W

Obliczona wartość mocy wydzielanej na cewce przekaźnika PPRZ jest wystarczająca, aby

przekaźnik działał poprawnie. Następnie obliczono wartość natężenia prądu bazy IB przy

pomocy uproszczonego wzoru na zależność natężenia prądu bazy od prądu kolektora. Mając

wartość natężenia tego prądu można obliczyć wartość szukanej rezystancji RB.

IB =

IC

hFE

(8)

IB =

0,034A
180 = 188 µA

Wzór opisujący drugie równanie Kirchhoffa dla oczka z bazą i emiterem:

UZAS = URB + UBE = IB ∙ RB − UBE (9)

UZAS − UBE = IB ∙ RB

RB =

(UZAS − UBE)
IB

RB =

(5 V − 0,72 V)
0,000188 A

=≈ 23kΩ

### 4.5. Prototypy

Układy prototypowe zostały zmontowane na płytkach stykowych. Ich celem jest

sprawdzenie poprawności działania oraz zmierzenia poszczególnych wartości układów. Na rys.

4.7 przedstawiony został prototyp układu odbiorczego nr 1. Dla którego pomierzono wartość

napięcia na wyjściu stabilizatora napięcia LM7805 podczas gdy układ zasilany jest z sieci.

Poprawna praca układu zależy od wartości doprowadzonego napięcia zasilania. Mikrokontroler

ATmega32 zasilany jest napięciem o stałej wartości 5 woltów i taką wartość zmierzył multimetr

na wyjściu stabilizatora napięcia. Dla układu odbiorczego nr 1 oraz nr 2 na wyjściu przekaźnika

dołączono diodę elektroluminescencyjną z szeregowo połączonym rezystorem w celu

sprawdzenia poprawności działania układów.

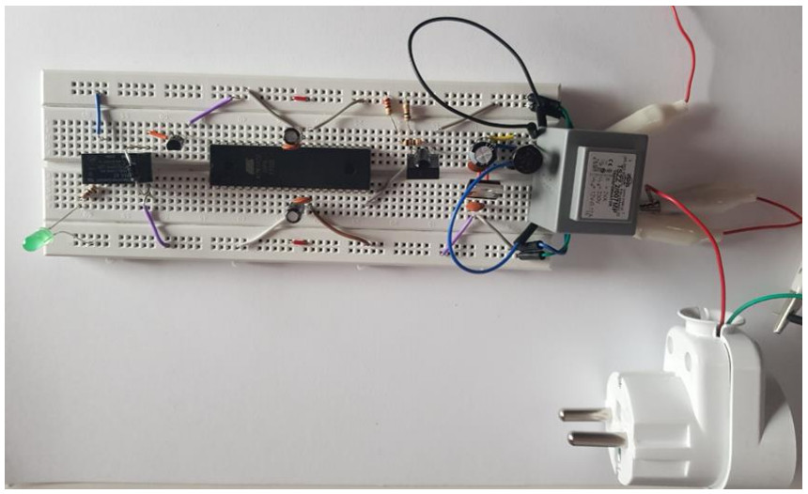
[picture p25: figure]

Rys. 4.7 Prototypowy układ odbiorczy nr 1 (opracowanie własne)

Za pomocą multimetru zmierzono wartości napięcia baza-emiter UBE, napięcia kolektor-

emiter UCE oraz natężenia prądu kolektora Ic dla układu odbiorczego nr 1 oraz nr 2. Napięcie

pomiędzy bazą, a emiterem jest zgodne z obliczoną wartością. Natężenie prądu kolektora

wynosi 31 miliamperów, a napięcie UCE jest równe 0,6 woltów. Pomierzone wartości

minimalnie odbiegają od założonych jednak są akceptowalne w celu poprawnej pracy układów.

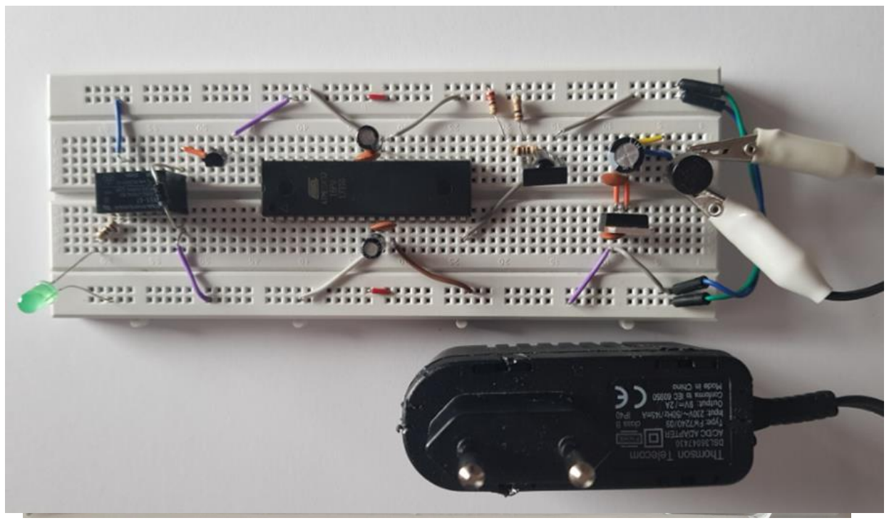
[picture p26: figure]

Rys. 4.8 Prototyp układu odbiorczego nr 2 (opracowanie własne)

Zaprezentowany na rys. 4.8 prototyp układu odbiorczego nr 2 zasilony został przy pomocy

zasilacza firmy Thomson telecom na którego wyjściu występuje napięcie o stałej wartości 9

woltów. Dzięki umieszczonemu mostkowi Graetza nie trzeba się martwić o poprawne

podłączenie zasilania. Korzystając z tego prototypu wykonano próby komunikacji układu

nadawczego z odbiorczym w pokoju o przestrzeni siedmiu metrów na pięć metrów

znajdujących się w punktach najdalej położonych od siebie. Pomiędzy układami nie wystąpiły

żadne błędy w komunikacji. Jedynym warunkiem było skierowanie diody podczerwieni w

stronę układu odbiorczego.

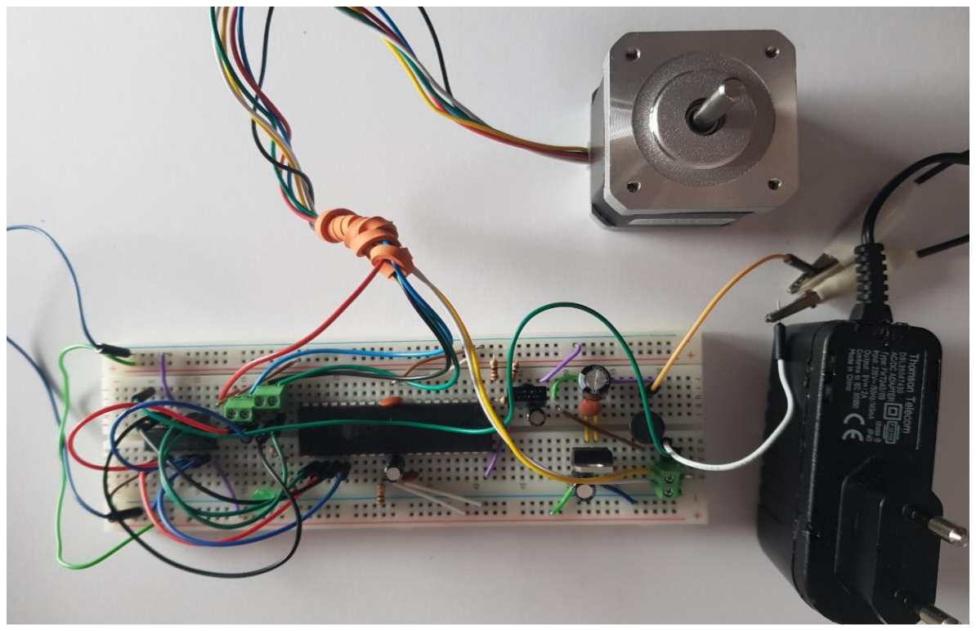
[picture p27: figure]

Rys. 4.9 Prototyp układu odbiorczego nr 3 (opracowanie własne)

Poprawność działania prototypu układu odbiorczego nr 3 pokazanego na rys. 4.9

sprawdzono korzystając z wcześniej zmontowanego prototypu układu nadawczego. Wysyłając

odpowiednią ramkę danych zaobserwowano obracanie się silnika. Z obserwacji wynika, że

układ działa poprawnie.

### 4.6. Oprogramowanie

Kod źródłowy układów odbiorczych zawiera bibliotekę złożoną z pliku źródłowego oraz

pliku nagłówkowego niezbędnego w celu udostępnienia biblioteki innym plikom źródłowym.

Biblioteka zawiera kod, który odpowiedzialny jest za dekodowanie sygnałów pochodzących z

odbiornika podczerwieni wykorzystując standard RC5. Kod źródłowy biblioteki inicjalizuje

pracę mikrokontrolera poprzez ustawienie portu PD6 jako wejście przy użyciu rejestru DDRD

w celu pobierania wartości napięcia z odbiornika podczerwieni i przypisania im odpowiedniego

stanu logicznego. Jeden z zegarów sprzętowych za pomocą rejestrów TCCR1B oraz TIMSK

ustawiony zostaje tak, aby mierzyć czasy trwania poszczególnych impulsów występujących na

porcie PD6 w celu stwierdzenia czy nadsyłana ramka danych jest prawidłowa i czy czas trwania

poszczególnych impulsów jest zgodny ze standardem RC5. Omawiany zegar sprzętowy

zaczyna zliczać czas trwania impulsów od momentu kiedy na PD6 pojawi się zbocze opadające

lub narastające występujące w środku każdego z nadsyłanych bitów. Mikrokontroler

rozpoznaje początek ramki poprzez wykrycie dwóch zboczy opadających bitów startu

występujących na jej początku. Po zakończeniu dekodowania ramki danych poszczególne wartości bitów zostają przypisane do zmiennych nazwanych adres, komenda oraz toggle, które

są wykorzystane w kodach źródłowych układów odbiorczych. W celu zmiany częstotliwości

taktowania mikrokontrolera ATmega32 z ustawionej produkcyjnie wartości 1 megaherca na

wartość 8 megaherców użyto programu Sinaprog przedstawionego na rysunku 4.10, ponieważ

darmowa wersja wcześniej użytego program mkAVRCalculator do ustawienia częstotliwości

taktowania mikrokontrolera ATtiny2313 nie obejmuje mikrokontrolera ATmega32.

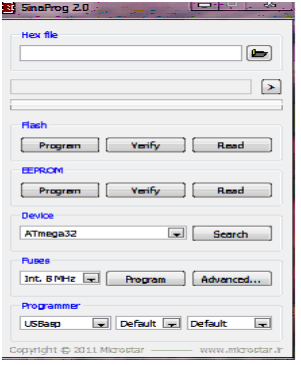
[picture p28: figure]

Rys. 4.10 Zrzut ekranu programu Sinaprog (opracowanie własne)

Kod źródłowy dla układu odbiorczego nr 1 powoduje pierw włączenie przekaźnika na

krótką chwilę podczas podłączania zasilania w celu sprawdzenia poprawności jego działania.

Następnie zostaje wykonana funkcja konfigurująca poszczególne rejestry mikrokontrolera w

celu poprawnej pracy z odbiornikiem podczerwieni w celu umożliwienia dekodowania

nadchodzących ramek od układu nadawczego. Funkcja została zdefiniowana w pliku biblioteki

opisanej powyżej. W pętli głównej programu sprawdzana jest pierw możliwość skorzystania ze

zmiennych do których przypisano wartości określające adres, komendę oraz wartość bitu toggle po poprawnym zdekodowaniu ramki danych, a następnie porównywane są wartości adresu i

komendy odebranej ramki danych z tymi, które założono w kodzie. Każdy z układów

odbiorczych zawiera inny adres oraz komendę na którą reaguje realizując odpowiednią funkcję.

Jeśli wartości te są równe, wtedy następuje zmiana stanu logicznego pinu PB0 na przeciwny,

co powoduje włączenie lub wyłączenie przekaźnika. Na końcu programu odebrane wartości

zdekodowanej ramki zostają wyzerowane, aby móc odebrać następną. Różnica w kodzie

pomiędzy układem odbiorczym nr 1, a układem odbiorczym numer 2 polega na tym, że układ

te reagują na odebraną ramkę danych o innych wartościach adresu oraz komendy. Program

realizujący sterowanie silnikiem krokowym unipolarnym przez układ odbiorczy nr 3 pierw

deklaruje, które piny zostaną wykorzystane do sterowania silnikiem. Następnie tworzy

makrodefinicje sterujące tymi pinami. Korzystając z rejestru DDRB oraz rejestru PORTB

ustawiono piny sterujące silnikiem jako wyjścia ze stanem niskim. Po odebraniu ramki

skierowanej do tego układu mikrokontroler porównuje odebrane wartości adresu oraz komendy

zawarte niej jeśli są równe z założonymi w kodzie tego programu to silnik zaczyna obracać się

w odpowiednią stronę podając za pomocą pętli odpowiedniej kolejności impulsów sterujących

silnikiem. Na końcu programu zerowane są wartości odebranej ramki danych, aby była

możliwość odbioru następnej.

### 5. Wykonanie układów

Układy zostały wykonane na płytkach uniwersalnych. Wykorzystano elementy

przystosowane do montażu przewlekanego, które zostały przylutowane do dolnej warstwy

płytek. Na rysunku 5.1 przedstawiono zmontowany układ nadawczy zbudowany w formie

pilota. Funkcję przycisków pełnią przełączniki typu microswitch.

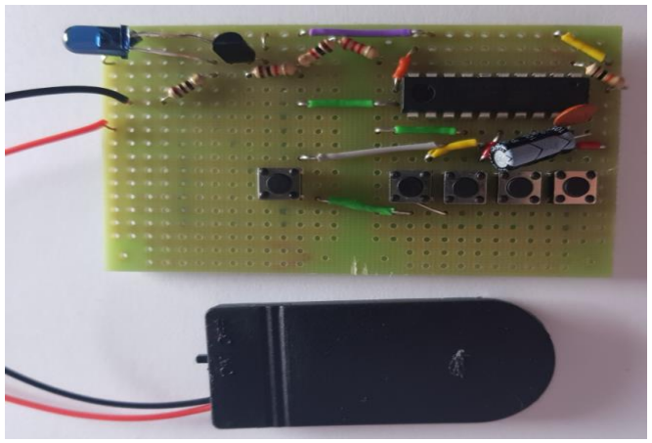
[picture p29: figure]

Rys. 5.1 Układ nadawczy (opracowanie własne)

Przedstawiony na rysunku 5.2 układ odbiorczy nr 1, który realizuje funkcję sterowania

gniazdkiem sieciowym. Złącze znajdujące się blisko przekaźnika zostało podłączone do

adaptera gniazdka sieciowego w sposób umożliwiający sterowanie przepływem prądu przez

urządzenia podłączone do adaptera. Blisko transformatora również znajduje się złącze. Jego

celem jest możliwość doprowadzenia energii elektrycznej do uzwojenia pierwotnego

transformatora w celu zasilenia układu.

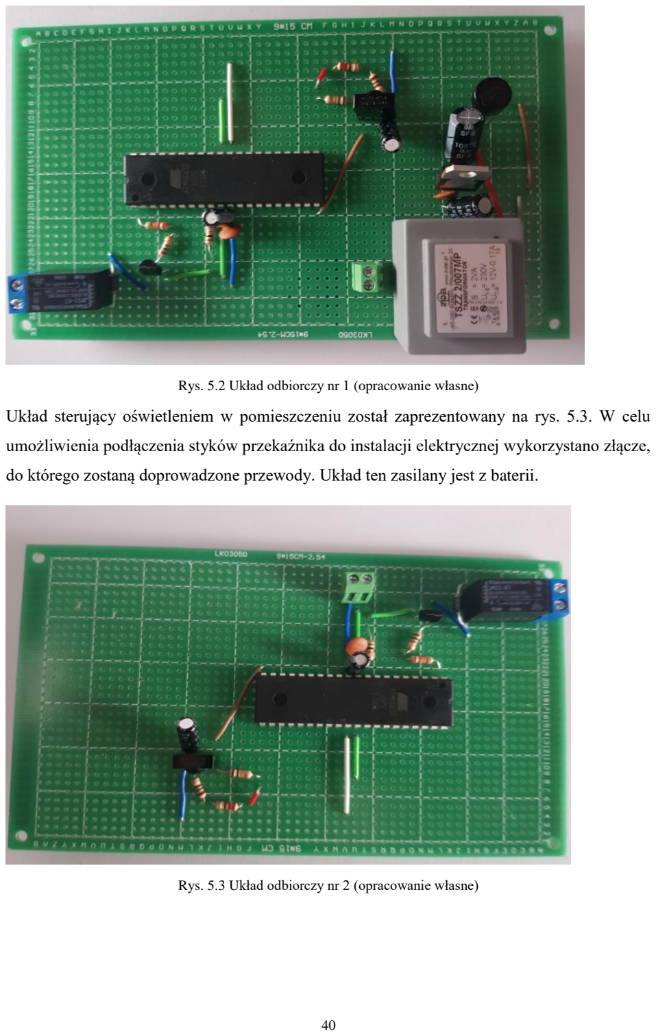
[picture p30: page 39]

Rys. 5.2 Układ odbiorczy nr 1 (opracowanie własne)

Układ sterujący oświetleniem w pomieszczeniu został zaprezentowany na rys. 5.3. W celu

umożliwienia podłączenia styków przekaźnika do instalacji elektrycznej wykorzystano złącze,

do którego zostaną doprowadzone przewody. Układ ten zasilany jest z baterii.

Rys. 5.3 Układ odbiorczy nr 2 (opracowanie własne)

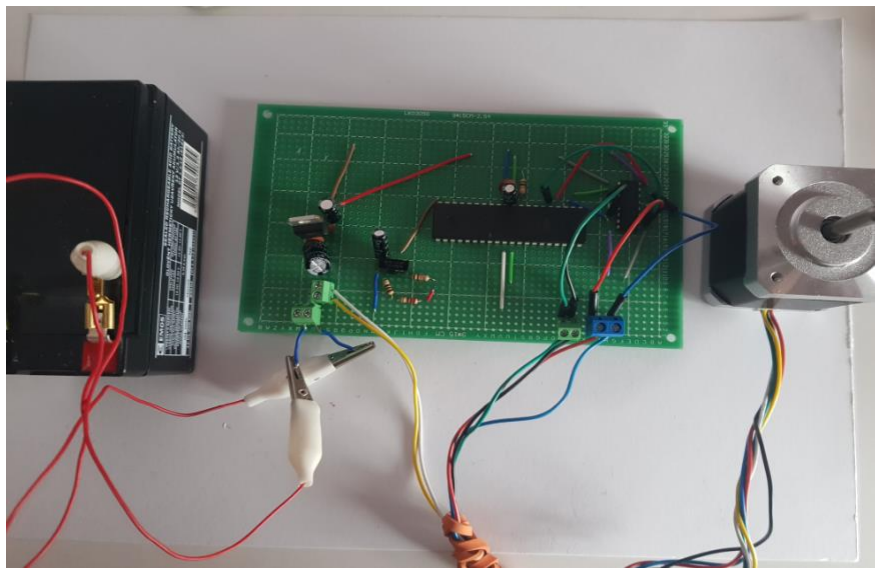
[picture p31: figure]

Rys. 5.4 Układ odbiorczy nr 3 (opracowanie własne)

Zaprezentowany na rys. 5.4 układ odbiorczy nr 3 zasilany jest akumulatorem ołowiowym.

Podczas jego wyboru kierowano się jego nominalnym napięciem wynoszącym 12 woltów,

wagą oraz pojemnością, która jest równa 1,3 amperogodziny. Zastosowane złącza mają na celu

umożliwić proste podłączanie akumulatora oraz silnika. Gdyby sterowana roleta okazała się

zbyt ciężka, a moment obrotowy silnika zbyt mały to wykorzystane złącza umożliwiają

podłączenie innego silnika.

Przy użyciu oscyloskopu dokonano sprawdzenia poprawności transmisji ramki danych z

układu nadawczego do układów odbiorczych. Do pierwszego kanału oscyloskopu podłączono

katodę oraz anodę diody podczerwieni, a sondę kanału drugiego podłączono do masy układu i

pinu PD6, który służy do dekodowania ramki danych. Rysunek 5.5 przedstawia przebiegi dla

układu nadawczego oraz układu odbiorczego nr 1. Na przedstawionych przebiegach można

zauważyć występujące w układzie nadawczym zakłócenia o częstotliwości 50 herców.

Powodowane są przez zasilacz impulsowy wykorzystany wcześniej dla układu prototypowego

nadajnika, a który użyto podczas badań w celu sprawdzenia poprawności transmisji przy braku

stałego napięcia zasilania dla jednego z układów. Układ odbiorczy nr 1 zasilono poprzez

zaprojektowany układ zasilania ciągłego, który jak widać na przebiegu spełnia swoje zadanie

utrzymania stabilnego napięcia stałego o wartości 5 woltów.

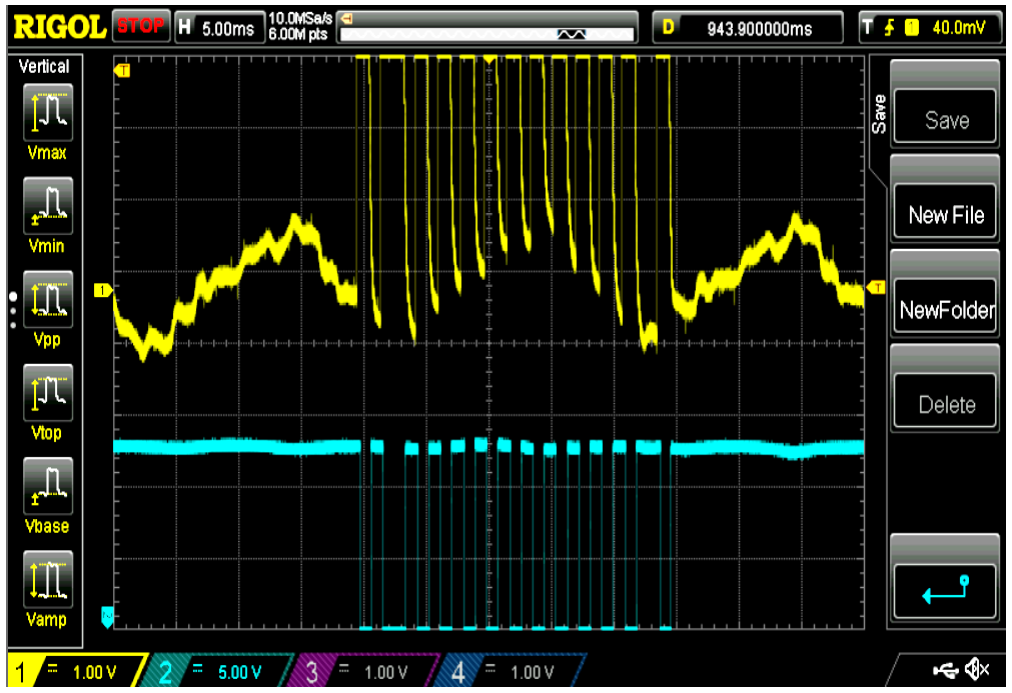
[picture p32: figure]

Rys. 5.5 Zrzut ekranu oscyloskopu obrazujący przebiegi ramek danych dla nadajnika oraz układu odbiorczego nr

1 (opracowanie własne)

Zaobserwowano poprawny odbiór ramki danych przez układ odbiorczy nr 1 pomimo zakłóceń

występujących w układzie nadawczym. Ramka danych wysłana z nadajnika składa się z 14

bitów, a także odebrana w układzie odbiorczym składa się z tej samej ilości bitów. Odebrana

wukładzie odbiorczym ramka danych została zanegowana przez odbiornik podczerwieni. Na

rys. 5.6 można zauważyć podobne przebiegi, jednak różnią się poszczególnymi bitami

odpowiedzialnymi za nadanie odpowiedniego adresu urządzenia oraz komendy. Wybrane

przyciski wysyłają odpowiednio zakodowaną ramkę danych umożliwiającą wykonanie

realizowanej funkcji przez układ odbiorczy przypisany do danego przycisku.

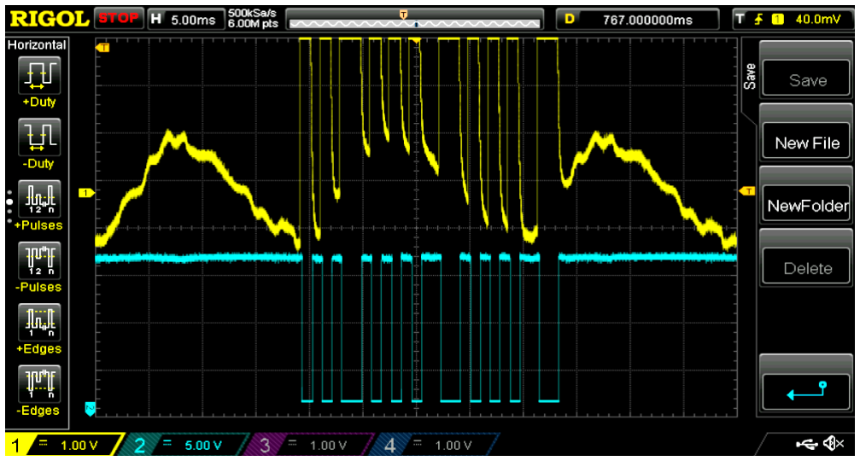
[picture p33: figure]

Rys. 5.6 Zrzut ekranu oscyloskopu obrazujący przebiegi ramek danych dla nadajnika oraz układu odbiorczego nr

2 (opracowanie własne)

Układ odbiorczy nr 3 został zasilony akumulatorem 12 woltowym. Dzięki użytemu

stabilizatorowi LM7805 utrzymywane jest stabilne napięcie zasilania układu o wartości 5

woltów, jak wynika z rys. 5.7. Podczas badania układów nie zauważono błędnego odbioru

ramek danych pomimo zakłóceń występujących w układzie nadawczym spowodowane użytym

zasilaczem impulsowym.

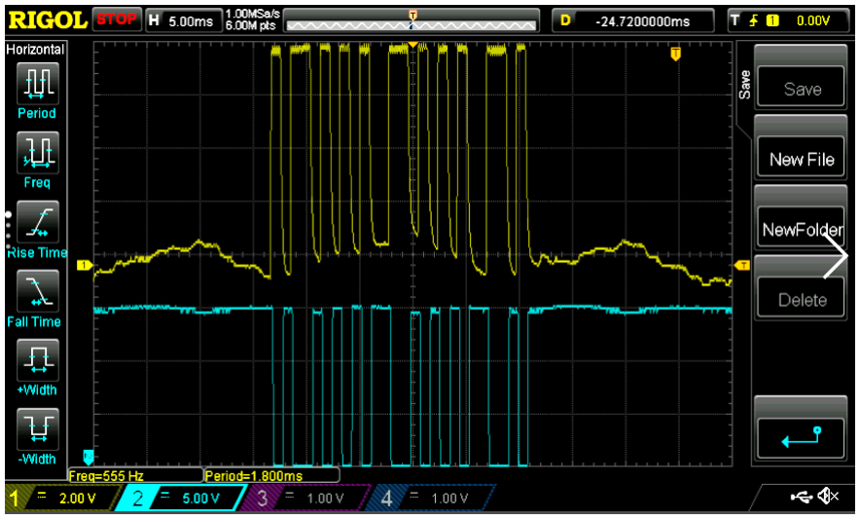
[picture p34: figure]

Rys. 5.7 Zrzut ekranu oscyloskopu obrazujący przebiegi ramek danych dla nadajnika oraz układu odbiorczego nr

3 (opracowanie własne)

### 6. Podsumowanie

Realizacja projektu pokazała w jaki sposób można skonstruować prosty system

zarządzający poszczególnymi funkcjami instalacji domowej. Małym kosztem finansowym

udało się zbudować jeden układ nadawczy w postaci pilota oraz trzy układy odbiorcze

realizujące sterowanie oświetleniem, roletą i gniazdem elektrycznym. Do komunikacji

pomiędzy układem nadawczym, a układami odbiorczymi wykorzystano standard RC5, który

pozwala na zaadresowanie ramki danych dla konkretnego układu odbiorczego w celu ich

odróżniania przez układ nadawczy oraz wysłania danych informujących jaką funkcję układy

mają wykonać.

Pomimo niższego natężenia prądu płynącego przez diodę podczerwieni w układzie

nadawczym w trakcie przesyłania ramki danych niż założono w projekcie komunikacja

pomiędzy układami odbywa się poprawnie. Podczas projektowania nadajnika podczerwieni

oraz fragmentu układów odbiorczych odpowiedzialnego za realizację sterowania

przekaźnikiem skorzystano z uproszczeń mających na celu wyznaczenia poszczególnych

wartości elementów. Wykonując pomiary zauważono, że wartości rzeczywiste poszczególnych

napięć tranzystora, współczynnika wzmocnienia oraz natężenia płynących prądów w

tranzystorze nieznacznie odbiega od wartości przedstawionych w notach katalogowych.

Wynika to z rozrzutu produkcyjnego parametrów tranzystora oraz ich zmiana spowodowana

zmianą temperatury jego pracy. Pierwotnie układy miałby być przygotowane na płytkach

miedzianych. Jednak po kilku nieudanych próbach przeniesienia układu połączeń na płytkę

miedzianą techniką termotransferu postanowiono wykorzystać płytki uniwersalne.

W przyszłość planowana jest rozbudowa systemu o dodatkowe układy odbiorcze realizujące

funkcje sterowania grzejnikiem, płynnej regulacji oświetleniem oraz monitorowania

pomieszczenia za pomocą kamery. Korzystając z Rasbberry Pi zostanie stworzona komunikacja

pomiędzy systemem a telefonem komórkowym.

BIBLIOGRAFIA

1. http://www.eae-elektronik.pl/automatyka-domowa/ (otwarto dnia 22.12.18)
2. yadda.icm.edu.pl/yadda/element/.../c/kurz_dariusz_porownanie_92_2017.pdf (pobrano dnia 02.01.19)

3.https://instalaton.pl/aktualnosci/28_systemy-inteligentnego-domu-charakterystyka-p.html (otwarto dnia 23.12.18)

4. http://www.xcomfort.pl/system (otwarto dnia 28.12.18)
5. http://www.eib.pl/media-transmisji-sygnalow-knx (17.01.19)
6. http://www.eib.pl/opis-ogolny-knx (otwarto dnia 4.01.19)
7. Kardaś M.: Mikrokontrolery AVR. Język C - podstawy programowania. Wydawnictwo: Atnel, Szczecin 2013, str. 329 - 347, 403 - 411.
8. https://forbot.pl/blog/kurs-elektroniki-ii-scalony-odbiornik-podczerwieni-tsop-id9641 (otwarto dnia 25.11.18)
9. https://forbot.pl/blog/kurs-budowy-robotow-zdalne-sterowanie-ir-rc5-id19364 (otwarto dnia 27.11.18)
10. https://forbot.pl/blog/kurs-raspberry-pi-od-podstaw-wstep-spis-tresci-id23139 (otwarto dnia 28.11.18)
11. https://forbot.pl/blog/kurs-arduino-srodowisko-jak-zaczac-programowac-id936 (otwarto dnia 28.11.18)
12. http://www.alldatasheet.com/datasheet-pdf/pdf/92890/ETC/L53F3BT.html (otwarto dnia
01.12.18) rys3.3
13. http://www.alldatasheet.com/datasheet-pdf/pdf/2898/MOTOROLA/BC558B.html (otwarto dnia 01.12.18)
14. http://www.alldatasheet.com/datasheet-pdf/pdf/2894/MOTOROLA/BC547B.html (otwarto dnia 02.12.18)
15. http://mirekk36.blogspot.com/2012/12/filtrowanie-zasilania-dlaczego-tak-wazne.html (otwarto dnia 5.12.18)
16. https://ea.elportal.pl/bipolarne.html (otwarto dnia 01.12.18)
17. http://www.mbmaster.pl/elektronika-tranzystor-bipolarny-npn-1.html (otwarto dnia 03.12.18)
18. http://www.alldatasheet.com/datasheet-pdf/pdf/77378/ATMEL/ATMEGA32.html (otwarto dnia 26.11.18)
19. http://www.alldatasheet.com/datasheet-pdf/pdf/80317/ATMEL/ATTINY2313.html (otwarto dnia 26.11.18)
20. http://www.alldatasheet.com/datasheet-pdf/pdf/22432/STMICROELECTRONICS/L293D.html (otwarto dnia 05.12.18)

21. http://www.alldatasheet.com/datasheet-pdf/pdf/26102/TEMIC/TFMS5360.html (otwarto dnia 03.12.18)
22. https://pl.mouser.com/datasheet/2/164/jv-18250.pdf (otwarto dnia 02.12.18)

SPIS RYSUNKÓW

rys. 2.1 Schemat blokowy systemu sterującego wybranymi funkcjami instalacji (opracowanie

własne) | str. 10

rys. 2.2 Przykładowa konstrukcja ramki danych w standardzie RC5 wysyłanej przez układ

nadawczy (opracowanie własne) | str. 11

rys. 2.3 Konstrukcja ramki danych odebranej przez mikrokontroler w układzie odbiorczym

(opracowanie własne) | str. 12

rys. 2.4 Reprezentacja stanów logiczny dla układu nadawczego z częstotliwością nośną 36

kiloherców (opracowanie własne) | str. 13

rys. 2.5 Reprezentacja stanów logiczny dla układu odbiorczego po odfiltrowaniu częstotliwości

nośnej przez odbiornik podczerwieni (opracowanie własne) | str. 14
rys. 3.1 Schemat połączeń dla układu nadawczego (opracowanie własne) | str. 16
rys. 3.2 Schemat nadajnika podczerwieni (opracowanie własne) | str. 17

rys. 3.3 Zależność Intensywności promieniowania diody L-53F3BT od długości emitowanej

fali [12] | str. 18

rys. 3.4 Zależność pomiędzy natężeniem prądu diody, a napięciem pracy diody L-53F3B

[12] | str. 19
rys. 3.5 Rozkład napięć i prądów nadajnika podczerwieni (opracowanie własne) | str. 20

rys. 3.6 Zależność między napięciem baza-emiter UBE, a prądem kolektora IC dla tranzystora

BC558B [13] | str. 21

rys. 3.7 Zależność wzmocnienia prądowego hFE od prądu kolektora IC dla tranzystora BC558B

[13] | str. 21
rys. 3.8 Prototyp układu nadawczego (opracowanie własne) | str. 23

rys. 3.9 Przebieg napięcia odkładanego na diodzie podczerwieni podczas emitowania fali

nośnej (opracowanie własne) | str. 24

rys. 3.10 Zrzut ekranu jednej z zakładek programu mkAVRCalculator (opracowanie

własne) | str.25
rys. 3.11 Programator USBasp (opracowanie własne) | str. 26
rys. 4.1 Schemat układu odbiorczego nr 1 (opracowanie własne) | str. 27
rys. 4.2 Schemat układu odbiorczego nr 2 (opracowanie własne) | str. 28
rys. 4.3 Schemat układu odbiorczego nr 3 (opracowanie własne) | str. 29

rys. 4.4 Część układu odbiorczego nr 1 oraz nr 2 sterująca przekaźnikiem (opracowanie

własne) | str. 32

rys. 4.5 Charakterystyka przedstawiająca zależność napięcia kolektor-emiter i napięcia baza-

emiter | od | natężenia | prądu | kolektora | dla | tranzystora | BC547B
[14] | str. 32

rys. 4.6 Rozkład napięć i prądów fragmentu układu odbiorczego nr 1 oraz nr 2 (opracowanie

własne) | str. 32
rys. 4.7 Prototypowy układ odbiorczy nr 1 (opracowanie własne) | str. 34
rys. 4.8 Prototyp układu odbiorczego nr 2 (opracowanie własne) | str. 35
rys. 4.9 Prototyp układu odbiorczego nr 3 (opracowanie własne) | str. 36
rys.4.10 Zrzut ekranu programu Sinaprog (opracowanie własne) | str. 37
rys. 5.1 Układ nadawczy (opracowanie własne) | str. 39
rys. 5.2 Układ odbiorczy nr 1 (opracowanie własne) | str. 40
rys. 5.3 Układ odbiorczy nr 2 (opracowanie własne) | str. 40
rys. 5.4 Układ odbiorczy nr 3 (opracowanie własne) | str.41

rys. 5.5 Zrzut ekranu oscyloskopu obrazujący przebiegi ramek danych dla nadajnika oraz

układu odbiorczego nr 1 (opracowanie własne) | str. 42

rys. 5.6 Zrzut ekranu oscyloskopu obrazujący przebiegi ramek danych dla nadajnika oraz

układu odbiorczego nr 2 (opracowanie własne) | str. 43

rys. 5.7 Zrzut ekranu oscyloskopu obrazujący przebiegi ramek danych dla nadajnika oraz

układu odbiorczego nr 3 (opracowanie własne) | str. 43

### 7. Załącznik

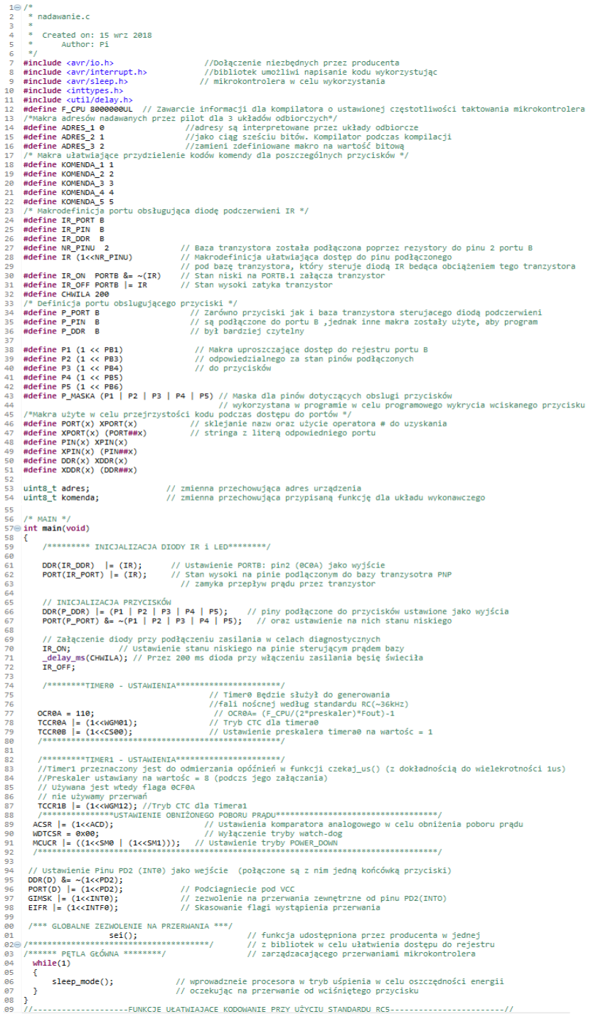
[picture p35: figure]

Kod źródłowy programu dla układu odbiorczego (opracowanie własne)

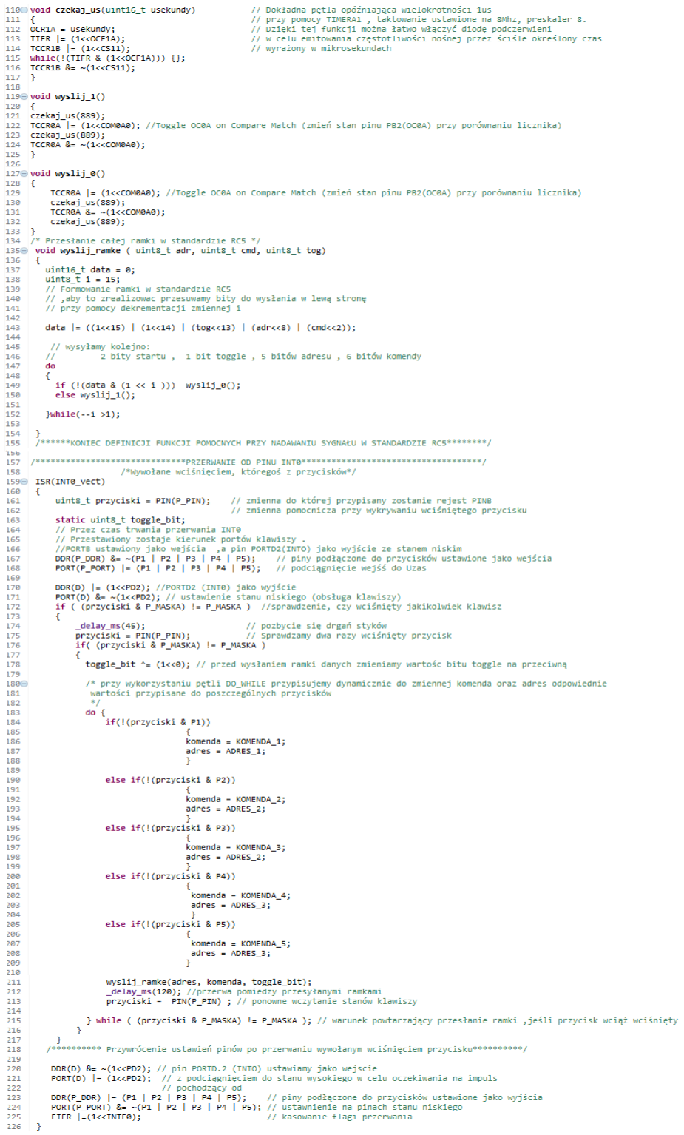
[picture p36: figure]

c.d. Kod źródłowy programu dla układu odbiorczego (opracowanie własne)

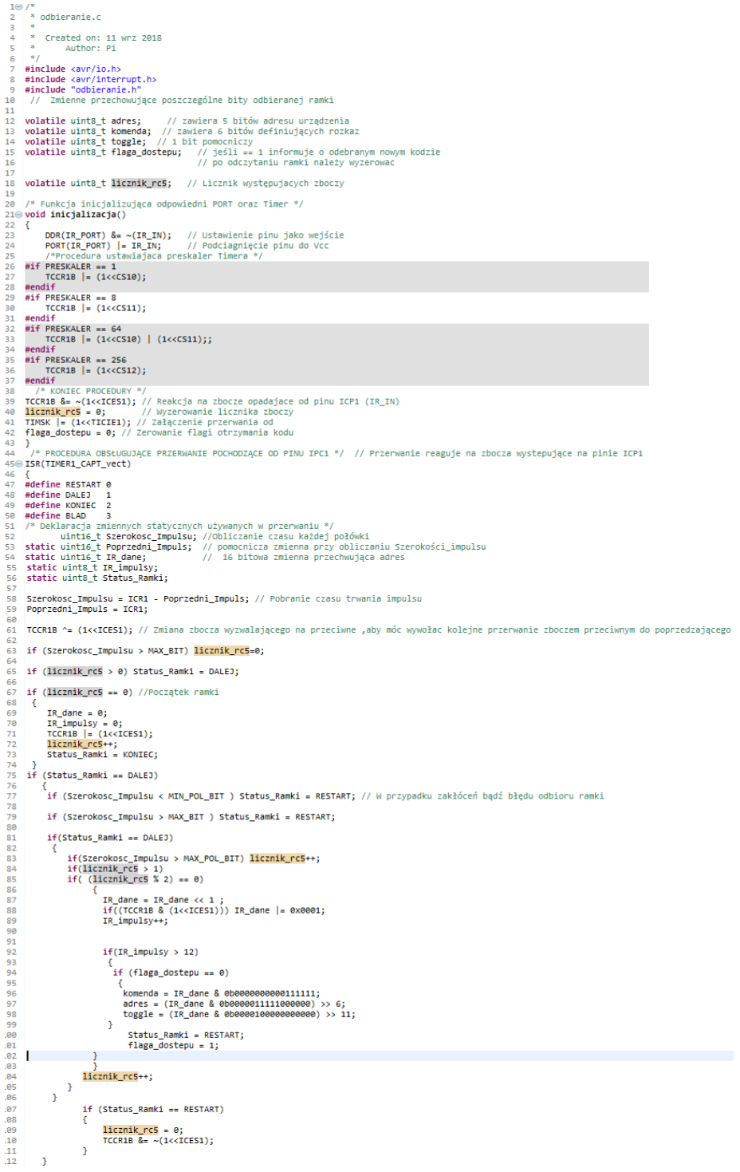
[picture p37: figure]

Kod źródłowy odpowiedzialny za dekodowanie sygnału (opracowanie własne)

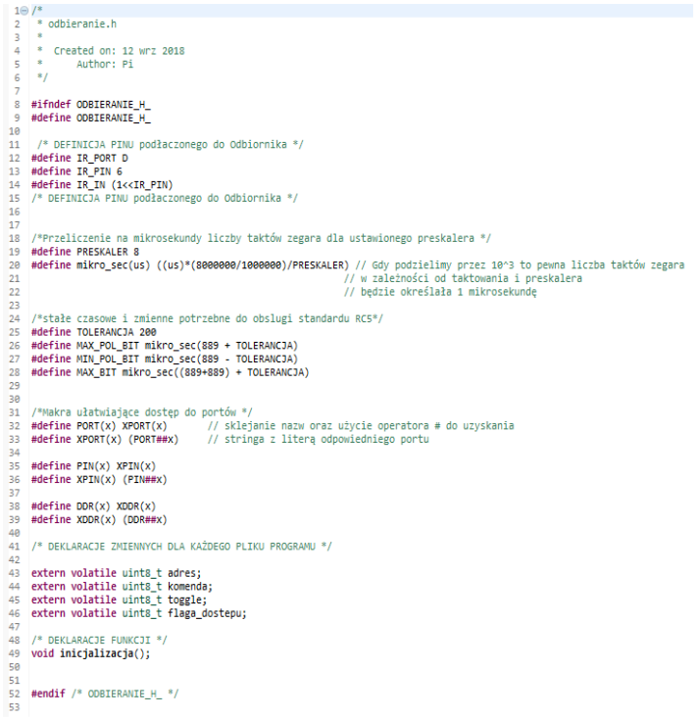
[picture p38: figure]

Plik nagłówkowy biblioteki odpowiedzialnej za dekodowanie sygnału (opracowanie własne)

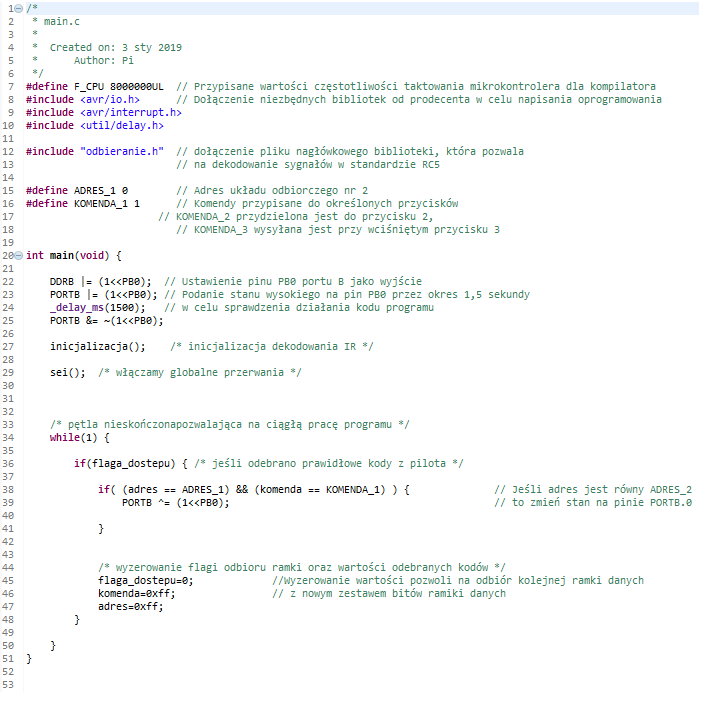
[picture p39: figure]

Kod źródłowy dla układu odbiorczego nr 1 (opracowanie własne)

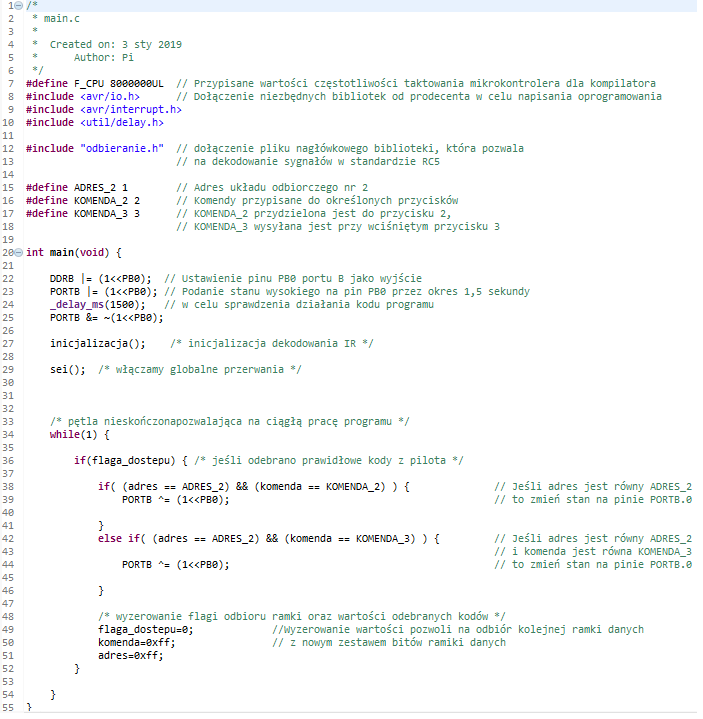
[picture p40: figure]

Kod źródłowy dla układu odbiorczego nr 2 (opracowanie własne)

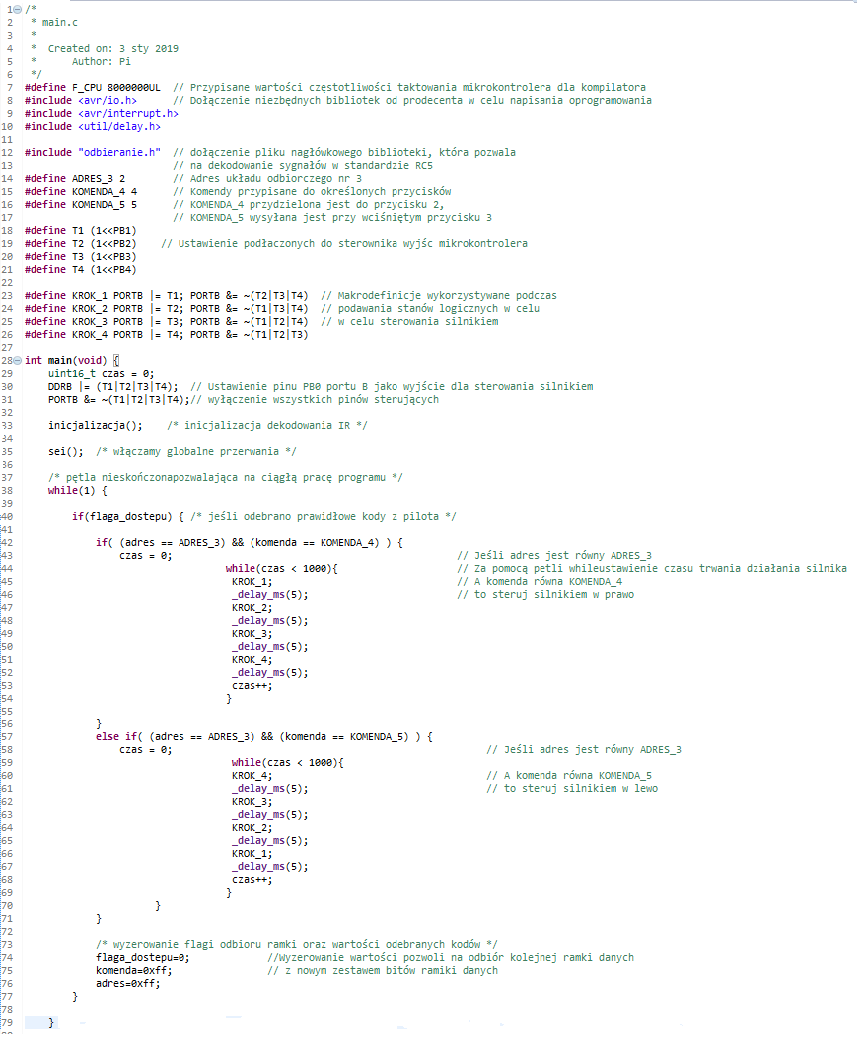
[picture p41: figure]

Kod źródłowy dla ukłądu odbiorczego nr 3 (opracowanie własne)

O Ś W I A D C Z E N I E

Ja niżej podpisany wyrażam zgodę na udostępnienie mojej pracy w

czytelni Archiwum WAT oraz w ramach wypożyczeń międzybibliotecznych.

Filip Mikołaj BAGIŃSKI

Warszawa, dnia |

Wykonano w jednym egzemplarzu.

### Warszawa, dnia |
