baginski95/Home-automation-system/pomiary/NewFile111.bmp

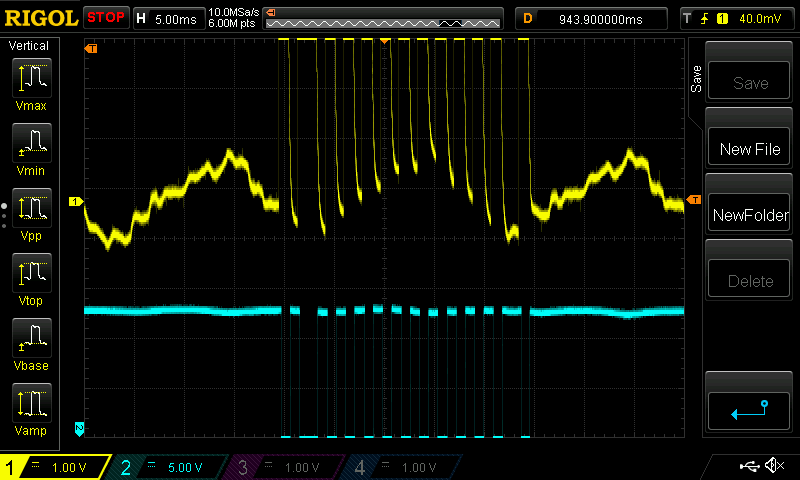
pomiary/NewFile111.bmp
