baginski95/Home-automation-system/pomiary/NewFile112.bmp

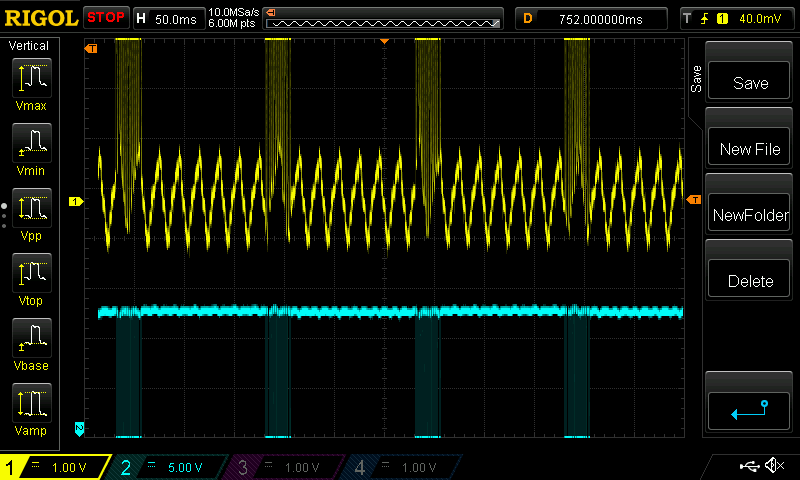
pomiary/NewFile112.bmp
