baginski95/Home-automation-system/pomiary/odb2/NewFile11.bmp

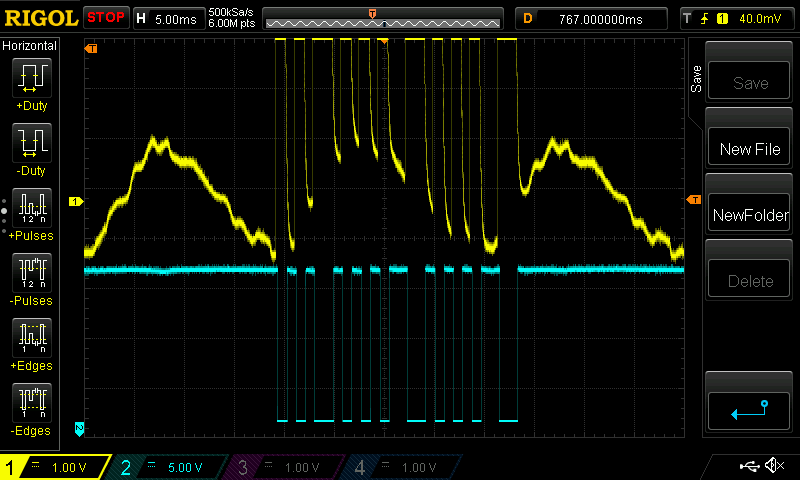
pomiary/odb2/NewFile11.bmp
