baginski95/Home-automation-system/pomiary/odb2/zasilanie_ładowarką_impulsową.bmp

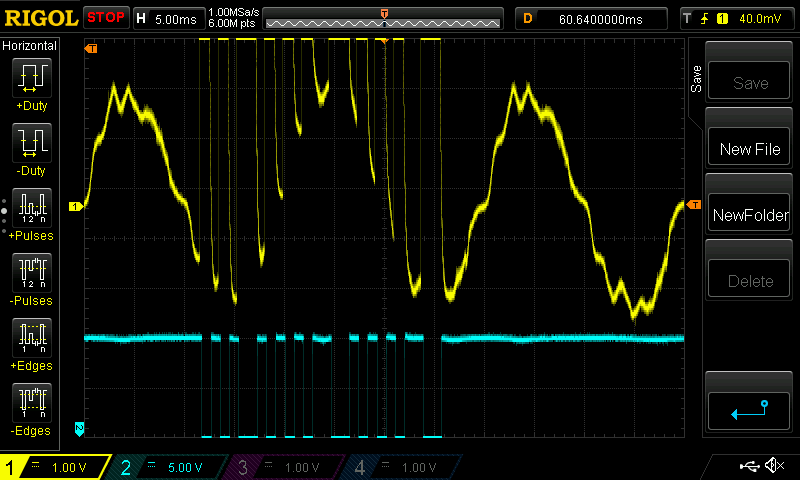
pomiary/odb2/zasilanie_ładowarką_impulsową.bmp
