baginski95/Home-automation-system/pomiary/ramka_Danych/ramki_danych.bmp

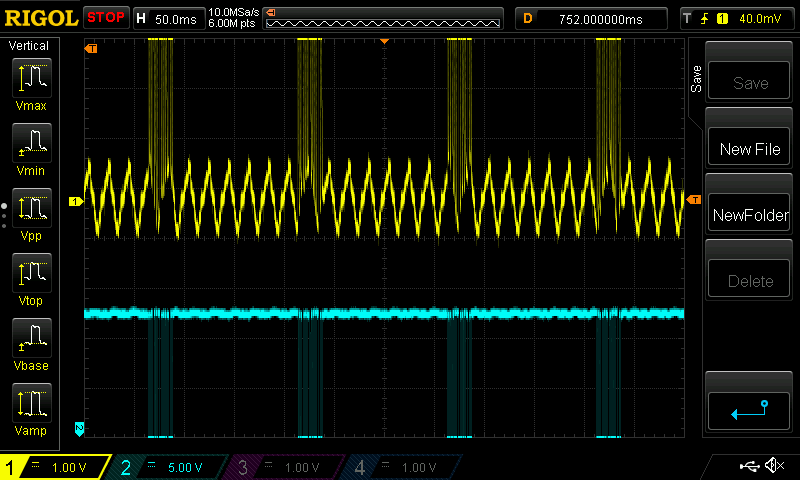
pomiary/ramka_Danych/ramki_danych.bmp
