baginski95/Home-automation-system/Schematy_układów/System_sterowania_układy_eagle/Nadajnik.sch

## EAGLE design Schematy_układów/System_sterowania_układy_eagle/Nadajnik.sch (2021-04-18)

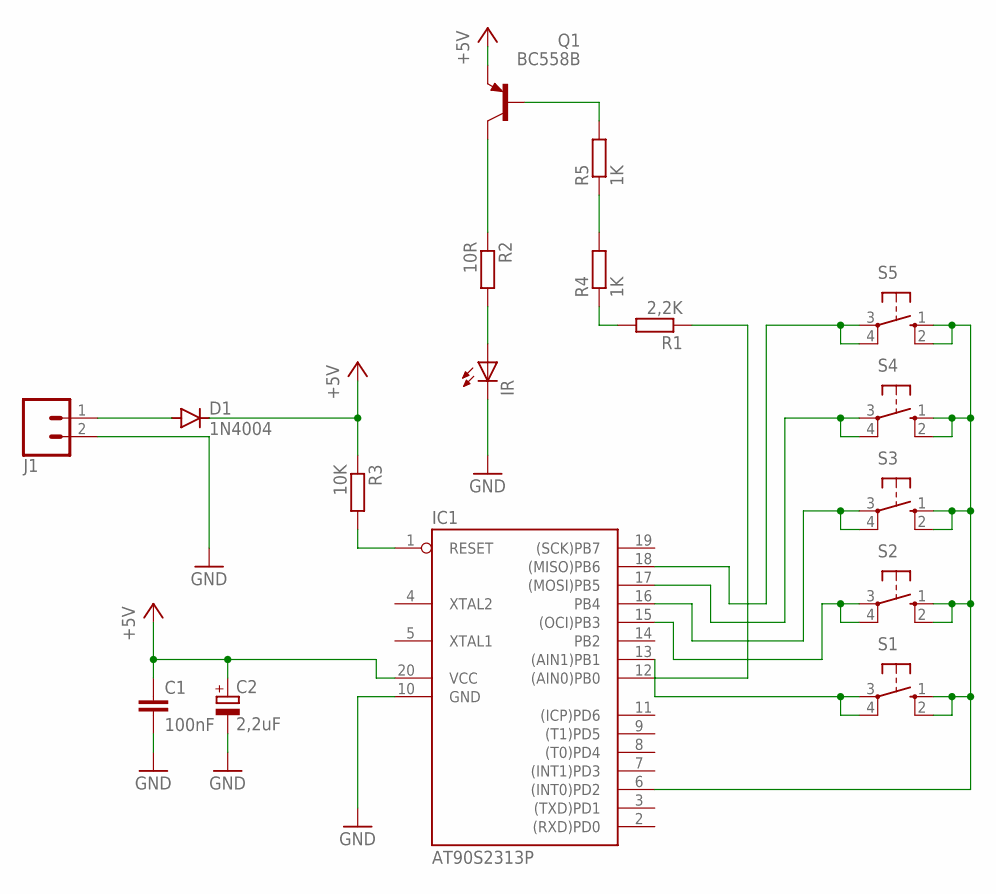
[picture p47: schematic Nadajnik.sch]

Parts:
C1: 100nF; C025-024X044
C2: 2,2uF; 140CLH-1010
D1: 1N4004; DO41-10
IC1: AT90S2313P; DIL20
IR: LED5MM
J1: CONN_02; 1X02
Q1: BC558B; TO92-EBC
R1: 2,2K; 0207/10
R2: 10R; 0207/10
R3: 10K; 0207/10
R4, R5: 1K; 0207/10
S1, S2, S3, S4, S5: 10-XX; B3F-10XX

Connections:
+5V: C1.1, C2.+, D1.C, IC1.20 (VCC), Q1.E, R3.1
GND: C1.2, C2.-, IC1.10 (GND), IR.K (C), J1.2
unnamed: IC1.12 ((AIN0)PB0), S1.3, S1.4 (P1)
unnamed: IC1.15 ((OCI)PB3), S2.3, S2.4 (P1)
unnamed: IC1.16 (PB4), S3.3, S3.4 (P1)
unnamed: IC1.17 ((MOSI)PB5), S4.3, S4.4 (P1)
unnamed: IC1.18 ((MISO)PB6), S5.3, S5.4 (P1)
unnamed: R1.2, R4.1
unnamed: IC1.13 ((AIN1)PB1), R1.1
unnamed: Q1.C, R2.1
unnamed: R4.2, R5.1
unnamed: IR.A, R2.2
unnamed: IC1.6 ((INT0)PD2), S1.1 (S), S1.2 (S1), S2.1 (S), S2.2 (S1), S3.1 (S), S3.2 (S1), S4.1 (S), S4.2 (S1), S5.1 (S), S5.2 (S1)
unnamed: Q1.B, R5.2
unnamed: D1.A, J1.1
unnamed: IC1.1 (RESET), R3.2
