baginski95/Home-automation-system/Schematy_układów/System_sterowania_układy_eagle/Odbiornik_1.sch

## EAGLE design Schematy_układów/System_sterowania_układy_eagle/Odbiornik_1.sch (2021-04-18)

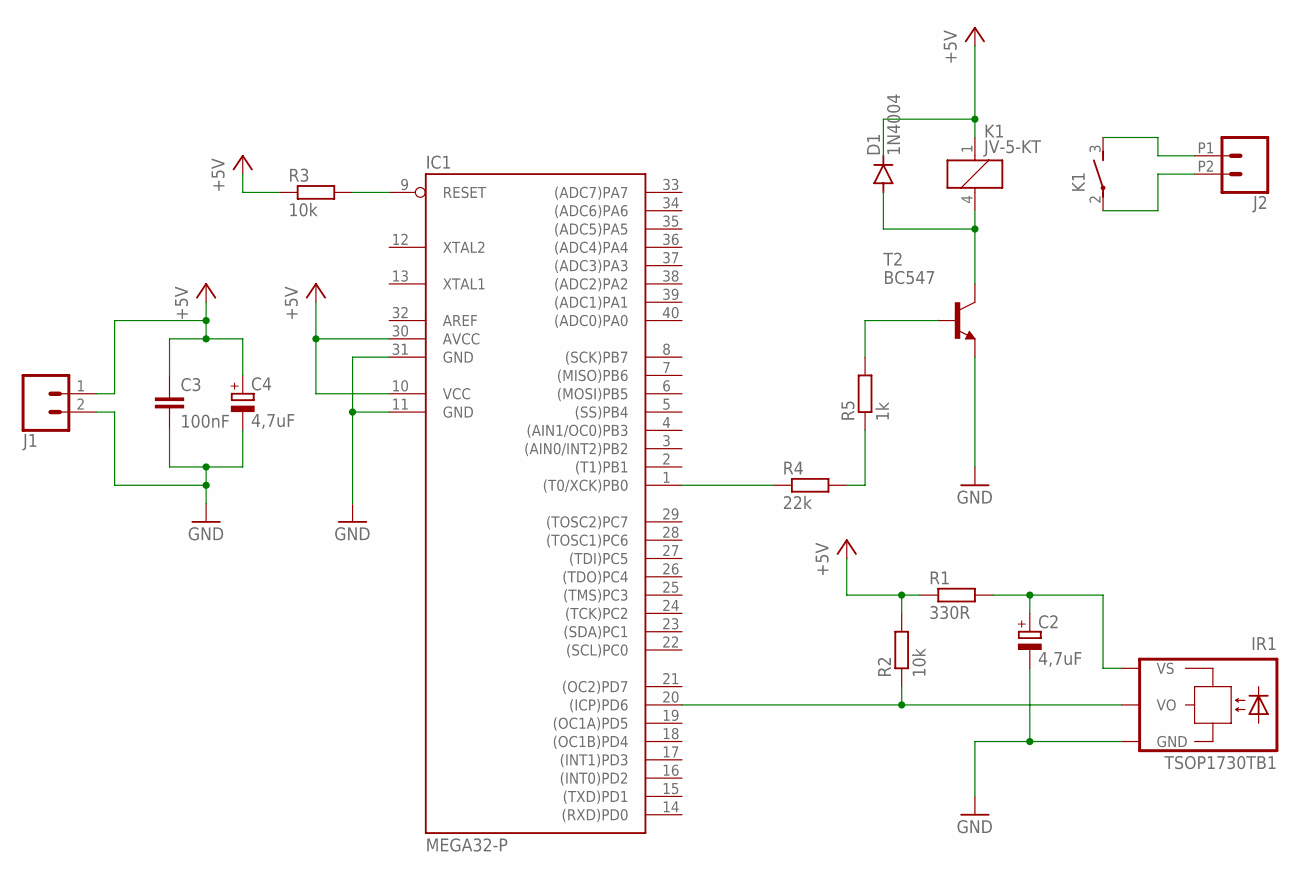
[picture p48: schematic Odbiornik_1.sch]

Parts:
C2, C4: 4,7uF; E2-4
C3: 100nF; C025-024X044
D1: 1N4004; DO41-10
IC1: MEGA32-P; DIL40
IR1: TSOP1730TB1; TSOP17_TB1
J1: CONN_02; 1X02
J2: CONN_022.54MM_SCREWTERM; 1X02_2.54_SCREWTERM
K1: JV-5-KT; JV-KT
R1: 330R; 0204/5
R2, R3: 10k; 0204/5
R4: 22k; 0204/5
R5: 1k; 0204/5
T2: BC547; TO92

Connections:
+5V: C3.1, C4.+, D1.C, IC1.10 (VCC), IC1.30 (AVCC), J1.1, K1.1, R1.1, R2.2, R3.1
GND: C2.-, C3.2, C4.-, IC1.11 (GND), IC1.31 (GND), IR1.GND, J1.2, T2.1 (E)
unnamed: IC1.20 ((ICP)PD6), IR1.VO, R2.1
unnamed: C2.+, IR1.VS, R1.2
unnamed: IC1.9 (RESET), R3.2
unnamed: IC1.1 ((T0/XCK)PB0), R4.1
unnamed: R4.2, R5.1
unnamed: D1.A, K1.4 (2), T2.3 (C)
unnamed: J2.P1 (1), K1.3 (S)
unnamed: J2.P2 (2), K1.2
unnamed: R5.2, T2.2 (B)
