baginski95/Home-automation-system/Schematy_układów/System_sterowania_układy_eagle/Odbiornik_2.sch

## EAGLE design Schematy_układów/System_sterowania_układy_eagle/Odbiornik_2.sch (2021-04-18)

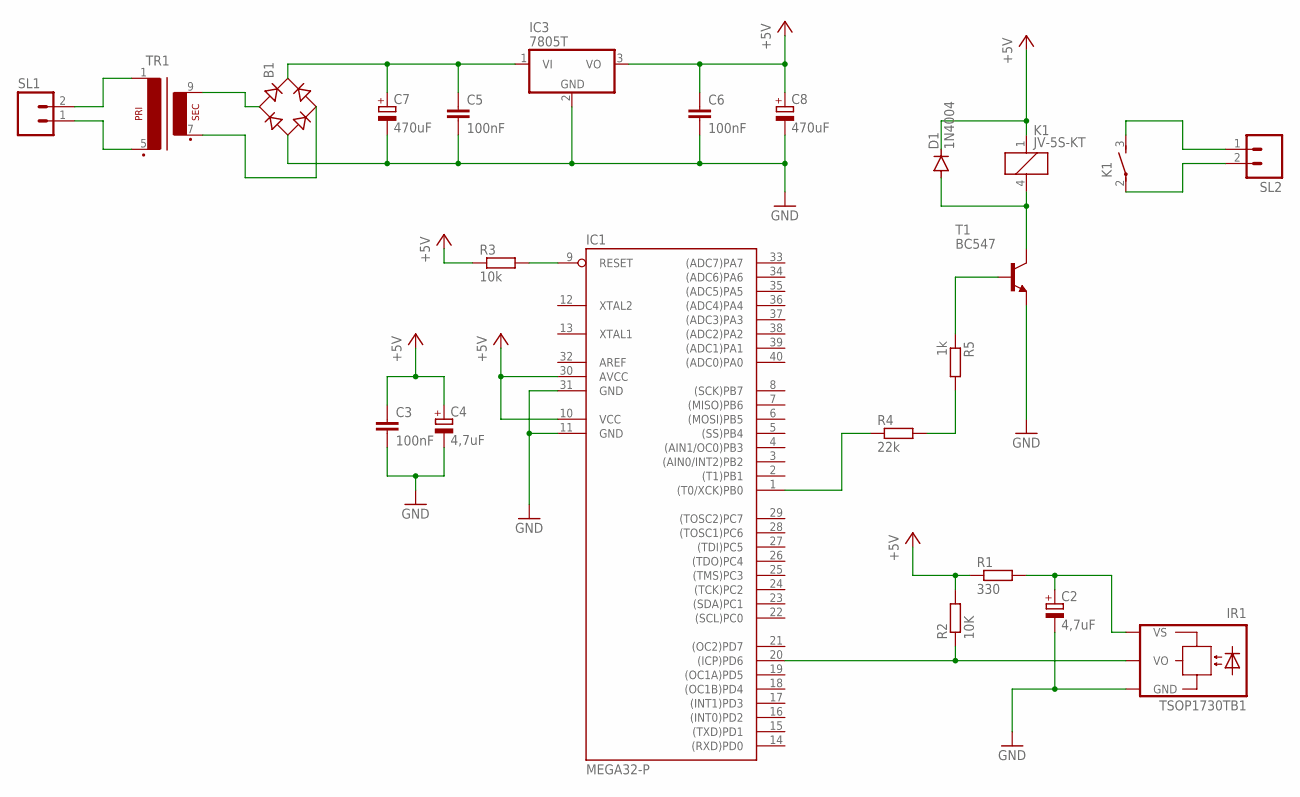
[picture p49: schematic Odbiornik_2.sch]

Parts:
B1: RB1A
C2, C4: 4,7uF; E2-4
C3, C5, C6: 100nF; C025-024X044
C7, C8: 470uF; E2-4
D1: 1N4004; DO41-10
IC1: MEGA32-P; DIL40
IC3: 7805T; TO220H
IR1: TSOP1730TB1; TSOP17_TB1
K1: JV-5S-KT; JV-KT
R1: 330; 0204/5
R2: 10K; 0204/5
R3: 10k; 0204/5
R4: 22k; 0204/5
R5: 1k; 0204/5
SL1, SL2: M02; 02P
T1: BC547; TO92
TR1: EI42-1

Connections:
+5V: C3.1, C4.+, C6.1, C8.+, D1.C, IC1.10 (VCC), IC1.30 (AVCC), IC3.3 (VO), K1.1, R1.1, R2.2, R3.1
GND: B1.-, C2.-, C3.2, C4.-, C5.2, C6.2, C7.-, C8.-, IC1.11 (GND), IC1.31 (GND), IC3.2 (GND), IR1.GND, T1.1 (E)
unnamed: IC1.20 ((ICP)PD6), IR1.VO, R2.1
unnamed: C2.+, IR1.VS, R1.2
unnamed: IC1.9 (RESET), R3.2
unnamed: IC1.1 ((T0/XCK)PB0), R4.1
unnamed: R4.2, R5.2
unnamed: R5.1, T1.2 (B)
unnamed: D1.A, K1.4 (2), T1.3 (C)
unnamed: B1.+, C5.1, C7.+, IC3.1 (VI)
unnamed: B1.AC2, TR1.7 (S3)
unnamed: SL1.2, TR1.1
unnamed: SL1.1, TR1.5 (P2)
unnamed: K1.2, SL2.2
unnamed: K1.3 (S), SL2.1
unnamed: B1.AC1, TR1.9 (S4)
