baginski95/Home-automation-system/Schematy_układów/System_sterowania_układy_eagle/Odbiornik_3.sch

## EAGLE design Schematy_układów/System_sterowania_układy_eagle/Odbiornik_3.sch (2021-04-18)

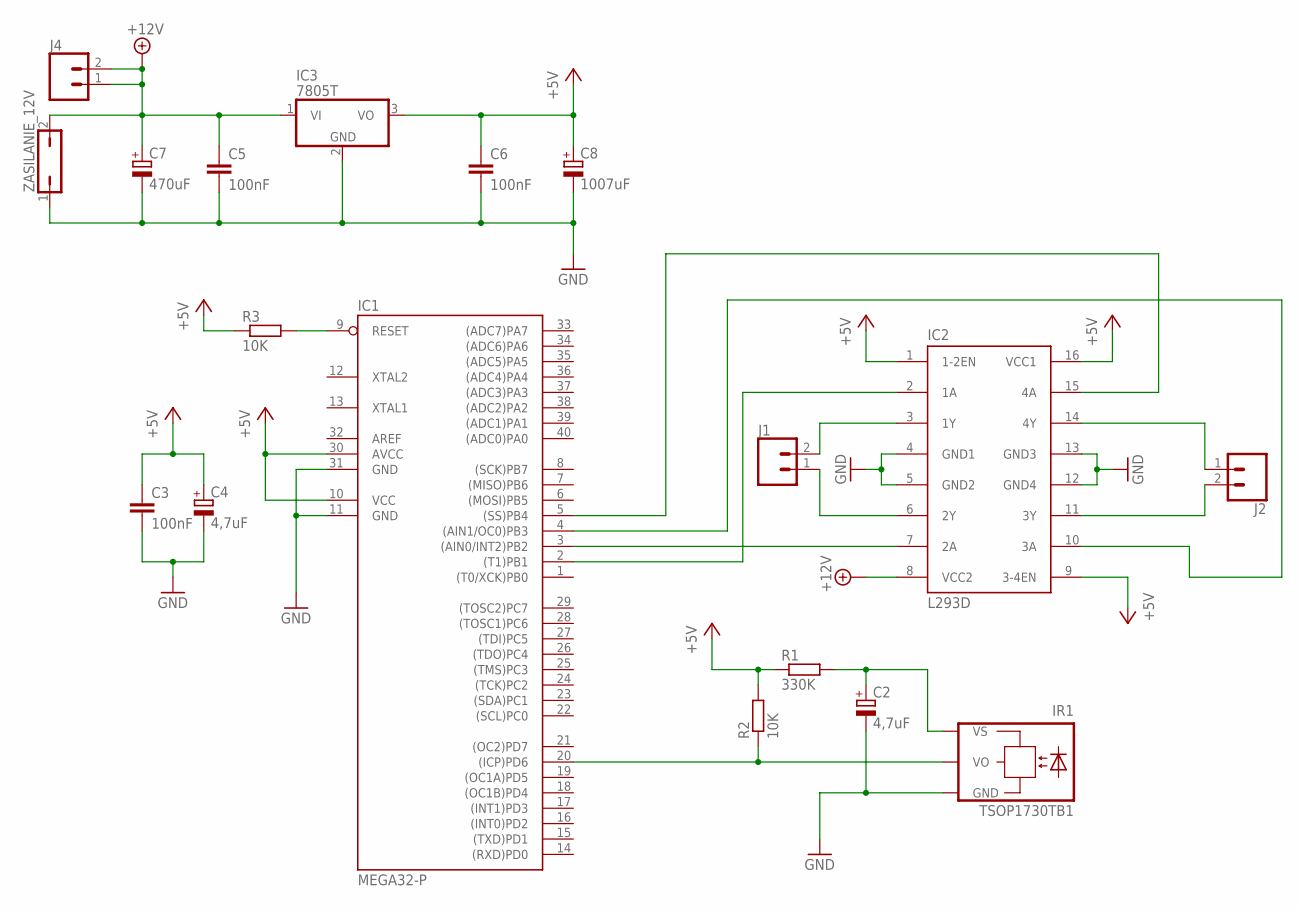
[picture p50: schematic Odbiornik_3.sch]

Parts:
C2, C4: 4,7uF; E2-4
C3, C5, C6: 100nF; C025-024X044
C7: 470uF; E2-4
C8: 1007uF; E2-4
IC1: MEGA32-P; DIL40
IC2: L293D; DIL16
IC3: 7805T; TO220H
IR1: TSOP1730TB1; TSOP17_TB1
J1, J2, J4: CONN_02; 1X02
R1: 330K; 0204/5
R2, R3: 10K; 0204/5
ZASILANIE_12V: JP1Q; JP1

Connections:
+5V: C3.1, C4.+, C6.1, C8.+, IC1.10 (VCC), IC1.30 (AVCC), IC2.1 (1-2EN), IC2.9 (3-4EN), IC2.16 (VCC1), IC3.3 (VO), R1.1, R2.2, R3.1
+12V: C5.1, C7.+, IC2.8 (VCC2), IC3.1 (VI), J4.1, J4.2, ZASILANIE_12V.2
GND: C2.-, C3.2, C4.-, C5.2, C6.2, C7.-, C8.-, IC1.11 (GND), IC1.31 (GND), IC2.4 (GND1), IC2.5 (GND2), IC2.12 (GND4), IC2.13 (GND3), IC3.2 (GND), IR1.GND, ZASILANIE_12V.1
unnamed: IC1.20 ((ICP)PD6), IR1.VO, R2.1
unnamed: C2.+, IR1.VS, R1.2
unnamed: IC1.9 (RESET), R3.2
unnamed: IC1.2 ((T1)PB1), IC2.2 (1A)
unnamed: IC1.3 ((AIN0/INT2)PB2), IC2.7 (2A)
unnamed: IC1.5 ((SS)PB4), IC2.15 (4A)
unnamed: IC1.4 ((AIN1/OC0)PB3), IC2.10 (3A)
unnamed: IC2.6 (2Y), J1.1
unnamed: IC2.3 (1Y), J1.2
unnamed: IC2.14 (4Y), J2.1
unnamed: IC2.11 (3Y), J2.2
